tobeca/Tobeca2/AMELIORATIONS CLIENTS/poussoir-protège-doigt-tea-innovation/images/poussoir_preview_featured.jpg

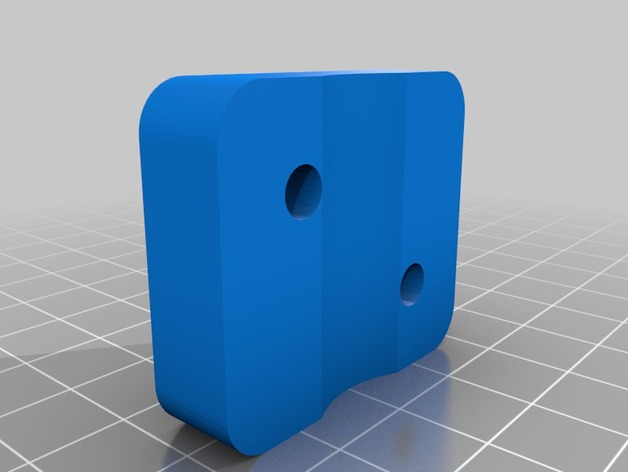
AMELIORATIONS CLIENTS/poussoir-protège-doigt-tea-innovation/images/poussoir_preview_featured.jpg
