tobeca/Tobeca2/AMELIORATIONS CLIENTS/poussoir-protège-doigt-tea-innovation/images/DSCF9553_preview_featured.JPG

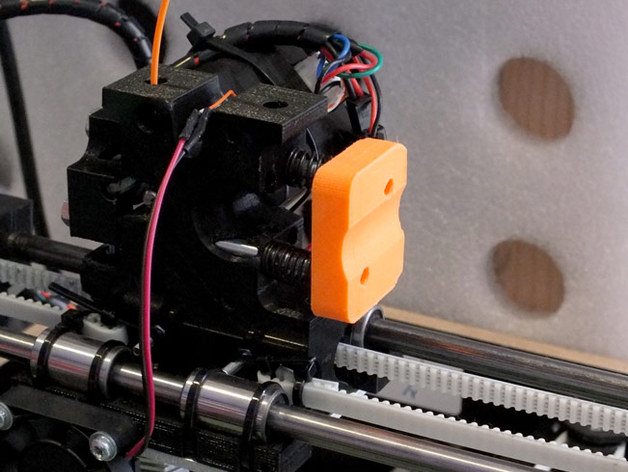
AMELIORATIONS CLIENTS/poussoir-protège-doigt-tea-innovation/images/DSCF9553_preview_featured.JPG
