tobeca/Tobeca2/README.md

<<<<<<< HEAD
Tobeca
======

The Tobeca 3D printer project
=======
Tobeca2
=======

The evolution of the 3D printer Tobeca
>>>>>>> 033404e43fc80d840fd945824806651eecf419e0
