tobeca/Tobeca2/AMELIORATIONS CLIENTS/Readme.txt

Ce dossier contient les pièces conçues et réalisées par des clients Tobeca en vue d'améliorer leur imprimante.

Elles ont été ajoutées ici par Tobeca, mais n'ont pas forcément été imprimées et testées par Tobeca. C'est pourquoi, toute modification de votre imprimante et sous votre pleine et entière responsabilité.

Si vous avez des pièces que vous jugez intéressantes à rajouter ici, merci de nous envoyer un mail à contact@tobeca.fr
