tobeca/Tobeca2/USINAGES/GCODE/CHASSIS_COTE_POIGNEE.txt

#Fichier modèle pour les perçages
#Il faut absolument respecter l'ordre suivant dans les modules : PARAMETRES, VARIABLES, INSTRUCTIONS

PARAMETRES{
	#Permet de stocker tous les paramètres de perçage/usinage qui serviront à la génération du GCODE
	ep_matiere=27; #épaisseur de la pièce à percer en mm
	marge_z=15; #marge Z au dessus de la pièce pour déplacements en mm
	f_deplacement=300; #vitesse de déplacement des axes mm/min
	f_descente=700; #vitesse du descente du forêt en mm/min
	z_passe_percer=1; #nombre de passes pour perçage
	off_x=3.5; #offset initial en X
	off_y=-1.5; #offset initial en Y
	accel=3000; #acceleration sur les déplacements
	d_fraise=3; #diamètre de la fraise
	z_passe_decouper=3; #nombre de passes pour l'usinage
	f_decoupe=500; #vitesse de découpe
	off_z=2; #offset initial en Z
	f_centrage=200; #vitesse de centrage du foret
}

VARIABLES{
	#Emplacement pour gérer directement des variables dans les instructions
	hauteur=85;
	longueur=396;
	dec_grenouille=0.5;
}

INSTRUCTIONS{
	#Positionnement des points de perçage percer, la première valeur est en X et la seconde est en Y.
	#trous du bas
	trou([55,4.5]);
	trou([165,4.5]);

	#trous planche droite
	trou([161,58]);
	trou([200,116.5]);
	trou([154,170]);
	trou([154,262]);
	trou([200,326.5]);
	trou([165,438.5]);

	#trous planche gauche
	trou([55,438.5]);
	trou([90,326.5]);
	trou([44,262]);
	trou([44,170]);
	trou([90,116.5]);
	trou([51,58]);

}
