tobeca/Tobeca2/USINAGES/GCODE/CHASSIS.txt

#Fichier modèle pour les perçages
#Il faut absolument respecter l'ordre suivant dans les modules : PARAMETRES, VARIABLES, INSTRUCTIONS

PARAMETRES{
	#Permet de stocker tous les paramètres de perçage/usinage qui serviront à la génération du GCODE
	ep_matiere=27; #épaisseur de la pièce à percer en mm
	marge_z=15; #marge Z au dessus de la pièce pour déplacements en mm
	f_deplacement=300; #vitesse de déplacement des axes mm/min
	f_descente=700; #vitesse du descente du forêt en mm/min
	z_passe_percer=1; #nombre de passes pour perçage
	off_x=3.5; #offset initial en X
	off_y=-1.5; #offset initial en Y
	accel=3000; #acceleration sur les déplacements
	d_fraise=3; #diamètre de la fraise
	z_passe_decouper=3; #nombre de passes pour l'usinage
	f_decoupe=500; #vitesse de découpe
	off_z=2; #offset initial en Z
	f_centrage=200; #vitesse de centrage du foret
}

VARIABLES{
	#Emplacement pour gérer directement des variables dans les instructions
	d_bord=4.5;
	longueur=443;
	largeur=414;
}

INSTRUCTIONS{
	trou([126,4.5]);
	trou([286,4.5]);

	#Trous de fixation du moteur
	trou([198.5,14]);
	trou([229.5,14]);
	trou([229.5,45]);
	trou([198.5,45]);

	#Trous de fixation du boitier électronique
	trou([190,87.5]);
	trou([238,168.5]);

	trou([largeur-4.5,145]);

	#Trous de fixation rangement écran LCD
	trou([380,272]);

	trou([largeur-4.5,300]);

	#Trous de fixation rangement écran LCD
	trou([380,429]);

	trou([286,longueur-4.5]);
	trou([126,longueur-4.5]);
	
	#Trous de fixation de l'alimentation électrique
	trou([234,403]);
	trou([194,248]);

	trou([4.5,300]);
	trou([4.5,145]);

}
