tobeca/Tobeca2/USINAGES/SUPPORT_AXE_X/SUPPORT_AXE_X_ALU.jpg

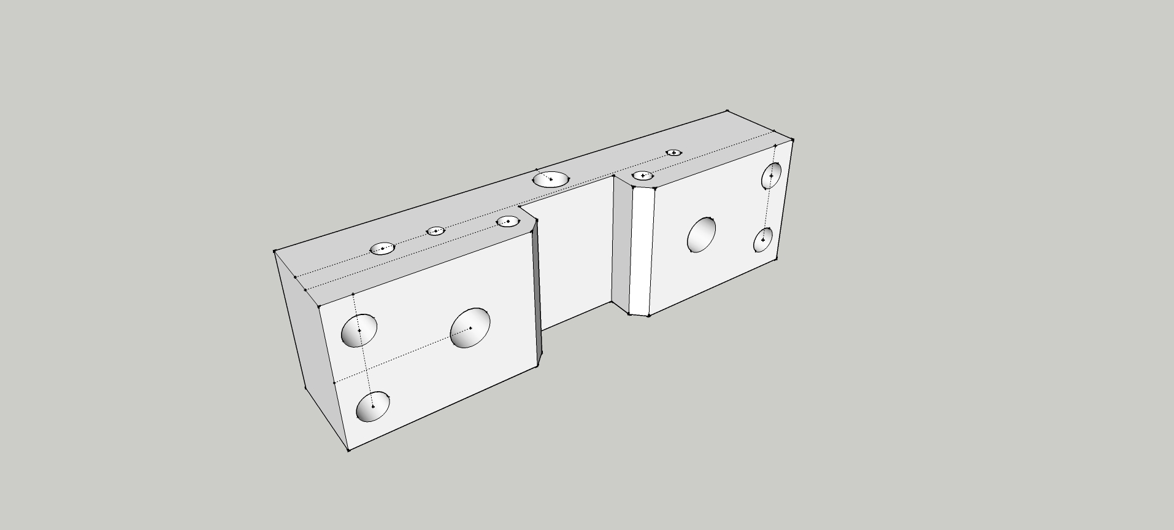
USINAGES/SUPPORT_AXE_X/SUPPORT_AXE_X_ALU.jpg
