tobeca/Tobeca2/PARTS LIST 3.3.ods

Sheet: Final
Préparation finale dans la boite |  |  |  | Préparation finale dans la boite
REF | Désignation | QTE | OK ? | REF | Désignation | QTE | OK ?
PLATEAU_PCB | Plateau chauffant PCB | 1 |  | PLATEAU_PCB | Plateau chauffant PCB | 1
THERM100K | Thermistance soudée sur le plateau ? | 1 |  | THERM100K | Thermistance soudée sur le plateau ? | 1
BOULEAU_210_210MM | Bouleau 9mm 210x210mm | 1 |  | BOULEAU_210_210MM | Bouleau 9mm 210x210mm | 1
 | Groupe guidages | 1 |  |  | Groupe guidages | 1
 | Groupe moteurs | 1 |  |  | Groupe moteurs | 1
HOTEND_1.75 | Tête d'impression avec ventilateurs | 1 |  | HOTEND_1.75 | Tête d'impression avec ventilateurs | 1
SMB-120-12 | Alimentation slim 12V 120W | 1 |  | SMB-120-12 | Alimentation slim 12V 120W | 1
POIGNEE_SANGLE | Poignée à sangle | 1 |  | POIGNEE_SANGLE | Poignée à sangle | 1
CABLE-IEC | Cordon secteur IEC mâle 2m | 1 |  | CABLE-IEC | Cordon secteur IEC mâle 2m | 1
CABLE-USB-AB | Cable USB A to B 3m | 1 |  | CABLE-USB-AB | Cable USB A to B 3m | 1
RALLONGE_USB | Rallonge USB | 1 |  | RALLONGE_USB | Rallonge USB | 1
COLLIER_NYLON_200MM | Colliers nylon 200mm | 30 |  | COLLIER_NYLON_200MM | Colliers nylon 200mm | 30
ETIQUETTE_CAPOT | Etiquette Tobeca pour capot | 1 |  | ETIQUETTE_CAPOT | Etiquette Tobeca pour capot | 1
 | Sachet de pièces imprimées | 1 |  |  | Sachet de pièces imprimées | 1
 | Sachet A | 1 |  |  | Sachet A | 1
 | Sachet B | 1 |  |  | Sachet B | 1
 | Sachet C | 1 |  |  | Sachet C | 1
 | Boite ou sachet Electronique | 1 |  |  | Boite ou sachet Electronique | 1
Préparation finale dans la boite |  |  |  | Préparation finale dans la boite
REF | Désignation | QTE | OK ? | REF | Désignation | QTE | OK ?
PLATEAU_PCB | Plateau chauffant PCB | 1 |  | PLATEAU_PCB | Plateau chauffant PCB | 1
THERM100K | Thermistance soudée sur le plateau ? | 1 |  | THERM100K | Thermistance soudée sur le plateau ? | 1
BOULEAU_210_210MM | Bouleau 9mm 210x210mm | 1 |  | BOULEAU_210_210MM | Bouleau 9mm 210x210mm | 1
 | Groupe guidages | 1 |  |  | Groupe guidages | 1
 | Groupe moteurs | 1 |  |  | Groupe moteurs | 1
HOTEND_1.75 | Tête d'impression avec ventilateurs | 1 |  | HOTEND_1.75 | Tête d'impression avec ventilateurs | 1
SMB-120-12 | Alimentation slim 12V 120W | 1 |  | SMB-120-12 | Alimentation slim 12V 120W | 1
POIGNEE_SANGLE | Poignée à sangle | 1 |  | POIGNEE_SANGLE | Poignée à sangle | 1
CABLE-IEC | Cordon secteur IEC mâle 2m | 1 |  | CABLE-IEC | Cordon secteur IEC mâle 2m | 1
CABLE-USB-AB | Cable USB A to B 3m | 1 |  | CABLE-USB-AB | Cable USB A to B 3m | 1
RALLONGE_USB | Rallonge USB | 1 |  | RALLONGE_USB | Rallonge USB | 1
COLLIER_NYLON_200MM | Colliers nylon 200mm | 30 |  | COLLIER_NYLON_200MM | Colliers nylon 200mm | 30
ETIQUETTE_CAPOT | Etiquette Tobeca pour capot | 1 |  | ETIQUETTE_CAPOT | Etiquette Tobeca pour capot | 1
 | Sachet de pièces imprimées | 1 |  |  | Sachet de pièces imprimées | 1
 | Sachet A | 1 |  |  | Sachet A | 1
 | Sachet B | 1 |  |  | Sachet B | 1
 | Sachet C | 1 |  |  | Sachet C | 1
 | Boite ou sachet Electronique | 1 |  |  | Boite ou sachet Electronique | 1

Sheet: Sachet A
SACHET A |  |  |  |  | SACHET A
REF | Désignation | QTE | OK ? |  | REF | Désignation | QTE | OK ?
TCBLZ03-008 | Vis M3x8mm tête bombée | 21 |  | 14,80g | TCBLZ03-008 | Vis M3x8mm tête bombée | 21 |  | 14,80g
TCBLZ03-012 | Vis M3x12mm tête bombée | 8 |  | 7g | TCBLZ03-012 | Vis M3x12mm tête bombée | 8 |  | 7g
TCBLZ03-020 | Vis M3x20mm tête bombée | 48 |  | 58g | TCBLZ03-020 | Vis M3x20mm tête bombée | 48 |  | 58g
TCBLZ03-030 | Vis M3x30mm tête bombée | 8 |  | 12,8g | TCBLZ03-030 | Vis M3x30mm tête bombée | 8 |  | 12,8g
TCBLZ03-040 | Vis M3x40mm tête bombée | 20 |  | 40,6g | TCBLZ03-040 | Vis M3x40mm tête bombée | 20 |  | 40,6g
TCBLZ03-060 | Vis M3x60mm tête bombée | 9 |  | 25,3g | TCBLZ03-060 | Vis M3x60mm tête bombée | 9 |  | 25,3g
TFZ03-016 | Vis M3x16mm tête fraisée | 40 |  | 30g | TFZ03-016 | Vis M3x16mm tête fraisée | 40 |  | 30g
TFZ03-020 | Vis M3x20mm tête fraisée | 8 |  | 7,3g | TFZ03-020 | Vis M3x20mm tête fraisée | 8 |  | 7,3g
TFZ03-050 | Vis M3x50mm tête fraisée | 6 |  | 10,5g | TFZ03-050 | Vis M3x50mm tête fraisée | 6 |  | 10,5g
TBHC05-014 | Vis M5x14mm 6 pans creux | 7 |  | 20g | TBHC05-014 | Vis M5x14mm 6 pans creux | 7 |  | 20g
TBHC06-035 | Vis M6x35mm 6 pans creux | 8 |  | 58g | TBHC06-035 | Vis M6x35mm 6 pans creux | 8 |  | 58g
VBATFZ03-010 | Vis agglo 3x10mm tête fraisée | 56 |  | 24,1g | VBATFZ03-010 | Vis agglo 3x10mm tête fraisée | 56 |  | 24,1g
RONM03 | Rondelles M3 standards | 136 |  | 34,6g | RONM03 | Rondelles M3 standards | 136 |  | 34,6g
ECRNYL03 | Ecrous nylstop M3 | 10 |  | 4,1g | ECRNYL03 | Ecrous nylstop M3 | 10 |  | 4,1g
ECRHU03 | Ecrous M3 | 100 |  | 33,3g | ECRHU03 | Ecrous M3 | 100 |  | 33,3g
ENTH03-010 | Ecrous M3 longs 10mm | 7 |  | 10,6g | ENTH03-010 | Ecrous M3 longs 10mm | 7 |  | 10,6g
ECRHU05 | Ecrous M5 | 2 |  |  | ECRHU05 | Ecrous M5 | 2
RONDM05 | Rondelles M5 | 2 |  |  | RONDM05 | Rondelles M5 | 2
ECRAIL08 | Ecrou M8 papillon | 1 |  |  | ECRAIL08 | Ecrou M8 papillon | 1
TH05-080 | Vis M5 80mm | 2 |  |  | TH05-080 | Vis M5 80mm | 2
TH08-100 | Vis M8x100mm | 1 |  |  | TH08-100 | Vis M8x100mm | 1
WJ200UM-11-10-LL | Patins Igus | 4 |  |  | WJ200UM-11-10-LL | Patins Igus | 4
RESSORT-10-25MM | Ressorts | 6 |  |  | RESSORT-10-25MM | Ressorts | 6
PIGNON_LAITON | Pignon laiton d'entraînement | 1 |  |  | PIGNON_LAITON | Pignon laiton d'entraînement | 1
POULIE-HTD3M-ALU | Poulie HTD3M aluminium | 2 |  |  | POULIE-HTD3M-ALU | Poulie HTD3M aluminium | 2
LM8UU | Douille linéaire 8mm | 4 |  |  | LM8UU | Douille linéaire 8mm | 4
FUSE1A | Fusible 1A 5x20mm | 2 |  |  | FUSE1A | Fusible 1A 5x20mm | 2
TUBE-12-80 | Tube inox 12mm 80mm | 1 |  |  | TUBE-12-80 | Tube inox 12mm 80mm | 1
605ZZ | Roulement 605ZZ | 3 |  |  | 605ZZ | Roulement 605ZZ | 3

Sheet: Sachet B
SACHET B |  |  |  | SACHET B
REF | Désignation | QTE | OK ? | REF | Désignation | QTE | OK ?
SC10UU | Boitier linéaire 10mm | 3 |  | SC10UU | Boitier linéaire 10mm | 3
IEC_C14 | Embase IEC C14 + interrupteur | 1 |  | IEC_C14 | Embase IEC C14 + interrupteur | 1
CABLE_NEMA17_200MM | Câble NEMA17 200mm | 1 |  | CABLE_NEMA17_200MM | Câble NEMA17 200mm | 1
CABLE_NEMA17_900MM | Câble NEMA17 900mm | 1 |  | CABLE_NEMA17_900MM | Câble NEMA17 900mm | 1
CABLE_NEMA17_1300MM | Câble NEMA17 1300mm | 1 |  | CABLE_NEMA17_1300MM | Câble NEMA17 1300mm | 1
ALU3-73x70 | Plaque alu 3mm 73x70mm | 1 |  | ALU3-73x70 | Plaque alu 3mm 73x70mm | 1
CABLE_RJ45 | Câble RJ45 (au m) | 1,5 |  | CABLE_RJ45 | Câble RJ45 (au m) | 1,5
CABLE2-075 | Câble double 0,75mm² (au m) | 1,5 |  | CABLE2-075 | Câble double 0,75mm² (au m) | 1,5
CABLEWRAP6 | Spirale de câbles | 2,5 |  | CABLEWRAP6 | Spirale de câbles | 2,5
CABLE-TERRE | Câble terre 1mm² | 10 cm |  | CABLE-TERRE | Câble terre 1mm² | 10 cm
GAINETHERMO_2MM | gaîne thermo 2mm (au m) | 10 cm |  | GAINETHERMO_2MM | gaîne thermo 2mm (au m) | 10 cm
COURROIE_HTD3M | HTD3M timing belt 840mm (au m) | 1 |  | COURROIE_HTD3M | HTD3M timing belt 840mm (au m) | 1
COURROIE_HTD3M | HTD3M timing belt 680mm (au m) | 1 |  | COURROIE_HTD3M | HTD3M timing belt 680mm (au m) | 1
SACHET B |  |  |  | SACHET B
REF | Désignation | QTE | OK ? | REF | Désignation | QTE | OK ?
SC10UU | Boitier linéaire 10mm | 3 |  | SC10UU | Boitier linéaire 10mm | 3
IEC_C14 | Embase IEC C14 + interrupteur | 1 |  | IEC_C14 | Embase IEC C14 + interrupteur | 1
CABLE_NEMA17_200MM | Câble NEMA17 200mm | 1 |  | CABLE_NEMA17_200MM | Câble NEMA17 200mm | 1
CABLE_NEMA17_900MM | Câble NEMA17 900mm | 1 |  | CABLE_NEMA17_900MM | Câble NEMA17 900mm | 1
CABLE_NEMA17_1300MM | Câble NEMA17 1300mm | 1 |  | CABLE_NEMA17_1300MM | Câble NEMA17 1300mm | 1
ALU3-73x70 | Plaque alu 3mm 73x70mm | 1 |  | ALU3-73x70 | Plaque alu 3mm 73x70mm | 1
CABLE_RJ45 | Câble RJ45 (au m) | 1,5 |  | CABLE_RJ45 | Câble RJ45 (au m) | 1,5
CABLE2-075 | Câble double 0,75mm² (au m) | 1,5 |  | CABLE2-075 | Câble double 0,75mm² (au m) | 1,5
CABLEWRAP6 | Spirale de câbles | 2,5 |  | CABLEWRAP6 | Spirale de câbles | 2,5
CABLE-TERRE | Câble terre 1mm² | 10 cm |  | CABLE-TERRE | Câble terre 1mm² | 10 cm
GAINETHERMO_2MM | gaîne thermo 2mm (au m) | 10 cm |  | GAINETHERMO_2MM | gaîne thermo 2mm (au m) | 10 cm
COURROIE_HTD3M | HTD3M timing belt 840mm (au m) | 1 |  | COURROIE_HTD3M | HTD3M timing belt 840mm (au m) | 1
COURROIE_HTD3M | HTD3M timing belt 680mm (au m) | 1 |  | COURROIE_HTD3M | HTD3M timing belt 680mm (au m) | 1
SACHET B |  |  |  | SACHET B
REF | Désignation | QTE | OK ? | REF | Désignation | QTE | OK ?
SC10UU | Boitier linéaire 10mm | 3 |  | SC10UU | Boitier linéaire 10mm | 3
IEC_C14 | Embase IEC C14 + interrupteur | 1 |  | IEC_C14 | Embase IEC C14 + interrupteur | 1
CABLE_NEMA17_200MM | Câble NEMA17 200mm | 1 |  | CABLE_NEMA17_200MM | Câble NEMA17 200mm | 1
CABLE_NEMA17_900MM | Câble NEMA17 900mm | 1 |  | CABLE_NEMA17_900MM | Câble NEMA17 900mm | 1
CABLE_NEMA17_1300MM | Câble NEMA17 1300mm | 1 |  | CABLE_NEMA17_1300MM | Câble NEMA17 1300mm | 1
ALU3-73x70 | Plaque alu 3mm 73x70mm | 1 |  | ALU3-73x70 | Plaque alu 3mm 73x70mm | 1
CABLE_RJ45 | Câble RJ45 (au m) | 1,5 |  | CABLE_RJ45 | Câble RJ45 (au m) | 1,5
CABLE2-075 | Câble double 0,75mm² (au m) | 1,5 |  | CABLE2-075 | Câble double 0,75mm² (au m) | 1,5
CABLEWRAP6 | Spirale de câbles | 2,5 |  | CABLEWRAP6 | Spirale de câbles | 2,5
CABLE-TERRE | Câble terre 1mm² | 10 cm |  | CABLE-TERRE | Câble terre 1mm² | 10 cm
GAINETHERMO_2MM | gaîne thermo 2mm (au m) | 10 cm |  | GAINETHERMO_2MM | gaîne thermo 2mm (au m) | 10 cm
COURROIE_HTD3M | HTD3M timing belt 840mm (au m) | 1 |  | COURROIE_HTD3M | HTD3M timing belt 840mm (au m) | 1
COURROIE_HTD3M | HTD3M timing belt 680mm (au m) | 1 |  | COURROIE_HTD3M | HTD3M timing belt 680mm (au m) | 1

Sheet: Sachet C
SACHET C |  |  |  | SACHET C
REF | Désignation | QTE | OK ? | REF | Désignation | QTE | OK ?
FAN404010 | Ventilateur 40x40x10mm | 1 |  | FAN404010 | Ventilateur 40x40x10mm | 1
FERMETURE_GRENOUILLE | Fermeture grenouille | 4 |  | FERMETURE_GRENOUILLE | Fermeture grenouille | 4
SUPPORT_AXE_X | SUPPORT_AXE_X aluminium | 2 |  | SUPPORT_AXE_X | SUPPORT_AXE_X aluminium | 2
COIN_METAL | Coin boule métal | 8 |  | COIN_METAL | Coin boule métal | 8
EQUERRE_METAL | Equerres de renfort | 8 |  | EQUERRE_METAL | Equerres de renfort | 8
COUPLAGE | Accouplement Z métal | 2 |  | COUPLAGE | Accouplement Z métal | 2
SACHET C |  |  |  | SACHET C
REF | Désignation | QTE | OK ? | REF | Désignation | QTE | OK ?
FAN404010 | Ventilateur 40x40x10mm | 1 |  | FAN404010 | Ventilateur 40x40x10mm | 1
FERMETURE_GRENOUILLE | Fermeture grenouille | 4 |  | FERMETURE_GRENOUILLE | Fermeture grenouille | 4
SUPPORT_AXE_X | SUPPORT_AXE_X aluminium | 2 |  | SUPPORT_AXE_X | SUPPORT_AXE_X aluminium | 2
COIN_METAL | Coin boule métal | 8 |  | COIN_METAL | Coin boule métal | 8
EQUERRE_METAL | Equerres de renfort | 8 |  | EQUERRE_METAL | Equerres de renfort | 8
COUPLAGE | Accouplement Z métal | 2 |  | COUPLAGE | Accouplement Z métal | 2
SACHET C |  |  |  | SACHET C
REF | Désignation | QTE | OK ? | REF | Désignation | QTE | OK ?
FAN404010 | Ventilateur 40x40x10mm | 1 |  | FAN404010 | Ventilateur 40x40x10mm | 1
FERMETURE_GRENOUILLE | Fermeture grenouille | 4 |  | FERMETURE_GRENOUILLE | Fermeture grenouille | 4
SUPPORT_AXE_X | SUPPORT_AXE_X aluminium | 2 |  | SUPPORT_AXE_X | SUPPORT_AXE_X aluminium | 2
COIN_METAL | Coin boule métal | 8 |  | COIN_METAL | Coin boule métal | 8
EQUERRE_METAL | Equerres de renfort | 8 |  | EQUERRE_METAL | Equerres de renfort | 8
COUPLAGE | Accouplement Z métal | 2 |  | COUPLAGE | Accouplement Z métal | 2
SACHET C |  |  |  | SACHET C
REF | Désignation | QTE | OK ? | REF | Désignation | QTE | OK ?
FAN404010 | Ventilateur 40x40x10mm | 1 |  | FAN404010 | Ventilateur 40x40x10mm | 1
FERMETURE_GRENOUILLE | Fermeture grenouille | 4 |  | FERMETURE_GRENOUILLE | Fermeture grenouille | 4
SUPPORT_AXE_X | SUPPORT_AXE_X aluminium | 2 |  | SUPPORT_AXE_X | SUPPORT_AXE_X aluminium | 2
COIN_METAL | Coin boule métal | 8 |  | COIN_METAL | Coin boule métal | 8
EQUERRE_METAL | Equerres de renfort | 8 |  | EQUERRE_METAL | Equerres de renfort | 8
COUPLAGE | Accouplement Z métal | 2 |  | COUPLAGE | Accouplement Z métal | 2
SACHET C |  |  |  | SACHET C
REF | Désignation | QTE | OK ? | REF | Désignation | QTE | OK ?
FAN404010 | Ventilateur 40x40x10mm | 1 |  | FAN404010 | Ventilateur 40x40x10mm | 1
FERMETURE_GRENOUILLE | Fermeture grenouille | 4 |  | FERMETURE_GRENOUILLE | Fermeture grenouille | 4
SUPPORT_AXE_X | SUPPORT_AXE_X aluminium | 2 |  | SUPPORT_AXE_X | SUPPORT_AXE_X aluminium | 2
COIN_METAL | Coin boule métal | 8 |  | COIN_METAL | Coin boule métal | 8
EQUERRE_METAL | Equerres de renfort | 8 |  | EQUERRE_METAL | Equerres de renfort | 8
COUPLAGE | Accouplement Z métal | 2 |  | COUPLAGE | Accouplement Z métal | 2

Sheet: Guidages
Guidages (groupe à buller et scotcher)
REF | Désignation | QTE | OK ?
WS_10_80_420 | Rail de guidage Drylin 420mm | 2
TIGEFIL-M5-330MM | Tige filetée M5 inox 330mm | 2
ARBRE10-425 | Arbre acier 10mm 425mm | 2
ARBRE8-361 | Arbre acier 8mm 361mm | 2
Guidages (groupe à buller et scotcher)
REF | Désignation | QTE | OK ?
WS_10_80_420 | Rail de guidage Drylin 420mm | 2
TIGEFIL-M5-330MM | Tige filetée M5 inox 330mm | 2
ARBRE10-425 | Arbre acier 10mm 425mm | 2
ARBRE8-361 | Arbre acier 8mm 361mm | 2
Guidages (groupe à buller et scotcher)
REF | Désignation | QTE | OK ?
WS_10_80_420 | Rail de guidage Drylin 420mm | 2
TIGEFIL-M5-330MM | Tige filetée M5 inox 330mm | 2
ARBRE10-425 | Arbre acier 10mm 425mm | 2
ARBRE8-361 | Arbre acier 8mm 361mm | 2
Guidages (groupe à buller et scotcher)
REF | Désignation | QTE | OK ?
WS_10_80_420 | Rail de guidage Drylin 420mm | 2
TIGEFIL-M5-330MM | Tige filetée M5 inox 330mm | 2
ARBRE10-425 | Arbre acier 10mm 425mm | 2
ARBRE8-361 | Arbre acier 8mm 361mm | 2
Guidages (groupe à buller et scotcher)
REF | Désignation | QTE | OK ?
WS_10_80_420 | Rail de guidage Drylin 420mm | 2
TIGEFIL-M5-330MM | Tige filetée M5 inox 330mm | 2
ARBRE10-425 | Arbre acier 10mm 425mm | 2
ARBRE8-361 | Arbre acier 8mm 361mm | 2
Guidages (groupe à buller et scotcher)
REF | Désignation | QTE | OK ?
WS_10_80_420 | Rail de guidage Drylin 420mm | 2
TIGEFIL-M5-330MM | Tige filetée M5 inox 330mm | 2
ARBRE10-425 | Arbre acier 10mm 425mm | 2
ARBRE8-361 | Arbre acier 8mm 361mm | 2
Guidages (groupe à buller et scotcher)
REF | Désignation | QTE | OK ?
WS_10_80_420 | Rail de guidage Drylin 420mm | 2
TIGEFIL-M5-330MM | Tige filetée M5 inox 330mm | 2
ARBRE10-425 | Arbre acier 10mm 425mm | 2
ARBRE8-361 | Arbre acier 8mm 361mm | 2

Sheet: Moteurs
Moteurs (buller ensemble)
REF | Désignation | QTE | OK ?
MT-1403HS100A-TB | Moteur NEMA14 | 2
MT-1704HS168A | Moteur NEMA17 | 3
Moteurs (buller ensemble)
REF | Désignation | QTE | OK ?
MT-1403HS100A-TB | Moteur NEMA14 | 2
MT-1704HS168A | Moteur NEMA17 | 3
Moteurs (buller ensemble)
REF | Désignation | QTE | OK ?
MT-1403HS100A-TB | Moteur NEMA14 | 2
MT-1704HS168A | Moteur NEMA17 | 3
Moteurs (buller ensemble)
REF | Désignation | QTE | OK ?
MT-1403HS100A-TB | Moteur NEMA14 | 2
MT-1704HS168A | Moteur NEMA17 | 3
Moteurs (buller ensemble)
REF | Désignation | QTE | OK ?
MT-1403HS100A-TB | Moteur NEMA14 | 2
MT-1704HS168A | Moteur NEMA17 | 3
Moteurs (buller ensemble)
REF | Désignation | QTE | OK ?
MT-1403HS100A-TB | Moteur NEMA14 | 2
MT-1704HS168A | Moteur NEMA17 | 3
Moteurs (buller ensemble)
REF | Désignation | QTE | OK ?
MT-1403HS100A-TB | Moteur NEMA14 | 2
MT-1704HS168A | Moteur NEMA17 | 3
Moteurs (buller ensemble)
REF | Désignation | QTE | OK ?
MT-1403HS100A-TB | Moteur NEMA14 | 2
MT-1704HS168A | Moteur NEMA17 | 3
Moteurs (buller ensemble)
REF | Désignation | QTE | OK ?
MT-1403HS100A-TB | Moteur NEMA14 | 2
MT-1704HS168A | Moteur NEMA17 | 3
Moteurs (buller ensemble)
REF | Désignation | QTE | OK ?
MT-1403HS100A-TB | Moteur NEMA14 | 2
MT-1704HS168A | Moteur NEMA17 | 3

Sheet: Pièces imprimées
Sachet de pièces imprimées |  |  | Sachet de pièces imprimées
Désignation | QTE | OK ? | Désignation | QTE | OK ?
BOITIER_RAMPS | 1 |  | BOITIER_RAMPS | 1
CAPOT_RAMPS | 1 |  | CAPOT_RAMPS | 1
PLAQUE_ARRIERE | 1 |  | PLAQUE_ARRIERE | 1
EXTRUDEUR | 1 |  | EXTRUDEUR | 1
CLIP_ENDSTOP_Y | 1 |  | CLIP_ENDSTOP_Y | 1
CLIP_PLATEAU | 1 |  | CLIP_PLATEAU | 1
EXTRUDEUR_SUPPORT_605ZZ | 1 |  | EXTRUDEUR_SUPPORT_605ZZ | 1
FIX_CHARIOT_X | 2 |  | FIX_CHARIOT_X | 2
MOLETTE_BASSE | 5 |  | MOLETTE_BASSE | 5
MOLETTE_GRANDE | 5 |  | MOLETTE_GRANDE | 5
PLAQUE_SERRAGE_FLANC | 2 |  | PLAQUE_SERRAGE_FLANC | 2
RETOUR_605ZZ | 2 |  | RETOUR_605ZZ | 2
RETOUR_X | 2 |  | RETOUR_X | 2
RETOUR_Y | 2 |  | RETOUR_Y | 2
RONDELLE_PLATEAU | 4 |  | RONDELLE_PLATEAU | 4
SUPPORT_AXE_Y | 4 |  | SUPPORT_AXE_Y | 4
SUPPORT_BOBINE | 2 |  | SUPPORT_BOBINE | 2
SUPPORT_ENDSTOP_X | 1 |  | SUPPORT_ENDSTOP_X | 1
SUPPORT_ENDSTOP_Z | 1 |  | SUPPORT_ENDSTOP_Z | 1
EQUERRE_NEMA_14 | 2 |  | EQUERRE_NEMA_14 | 2
Sachet de pièces imprimées |  |  | Sachet de pièces imprimées
Désignation | QTE | OK ? | Désignation | QTE | OK ?
BOITIER_RAMPS | 1 |  | BOITIER_RAMPS | 1
CAPOT_RAMPS | 1 |  | CAPOT_RAMPS | 1
PLAQUE_ARRIERE | 1 |  | PLAQUE_ARRIERE | 1
EXTRUDEUR | 1 |  | EXTRUDEUR | 1
CLIP_ENDSTOP_Y | 1 |  | CLIP_ENDSTOP_Y | 1
CLIP_PLATEAU | 1 |  | CLIP_PLATEAU | 1
EXTRUDEUR_SUPPORT_605ZZ | 1 |  | EXTRUDEUR_SUPPORT_605ZZ | 1
FIX_CHARIOT_X | 2 |  | FIX_CHARIOT_X | 2
MOLETTE_BASSE | 5 |  | MOLETTE_BASSE | 5
MOLETTE_GRANDE | 5 |  | MOLETTE_GRANDE | 5
PLAQUE_SERRAGE_FLANC | 2 |  | PLAQUE_SERRAGE_FLANC | 2
RETOUR_605ZZ | 2 |  | RETOUR_605ZZ | 2
RETOUR_X | 2 |  | RETOUR_X | 2
RETOUR_Y | 2 |  | RETOUR_Y | 2
RONDELLE_PLATEAU | 4 |  | RONDELLE_PLATEAU | 4
SUPPORT_AXE_Y | 4 |  | SUPPORT_AXE_Y | 4
SUPPORT_BOBINE | 2 |  | SUPPORT_BOBINE | 2
SUPPORT_ENDSTOP_X | 1 |  | SUPPORT_ENDSTOP_X | 1
SUPPORT_ENDSTOP_Z | 1 |  | SUPPORT_ENDSTOP_Z | 1
EQUERRE_NEMA_14 | 2 |  | EQUERRE_NEMA_14 | 2

Sheet: Kit Double Extrudeur
Sachet pour kit double extrudeur |  |  |  | Sachet pour kit double extrudeur
REF | Désignation | QTE | OK ? | REF | Désignation | QTE | OK ?
TBHC05-014 | Vis M5x14mm 6 pans creux | 1 |  | TBHC05-014 | Vis M5x14mm 6 pans creux | 1
RONM05 | Rondelles M5 | 2 |  | RONM05 | Rondelles M5 | 2
ECRHU05 | Ecrous M5 | 2 |  | ECRHU05 | Ecrous M5 | 2
ECRAIL08 | Ecrou M8 papillon | 1 |  | ECRAIL08 | Ecrou M8 papillon | 1
TH05-080 | Vis M5 80mm | 2 |  | TH05-080 | Vis M5 80mm | 2
TH08-100 | Vis M8x100mm | 1 |  | TH08-100 | Vis M8x100mm | 1
RESSORT-10-25MM | Ressorts | 2 |  | RESSORT-10-25MM | Ressorts | 2
PIGNON_LAITON | Pignon laiton d'entraînement | 1 |  | PIGNON_LAITON | Pignon laiton d'entraînement | 1
TUBE-12-80 | Tube inox 12mm 80mm | 1 |  | TUBE-12-80 | Tube inox 12mm 80mm | 1
605ZZ | Roulement 605ZZ | 1 |  | 605ZZ | Roulement 605ZZ | 1
CABLE_NEMA17_1300MM | Câble NEMA17 1300mm | 1 |  | CABLE_NEMA17_1300MM | Câble NEMA17 1300mm | 1
MT-1704HS168A | Moteur NEMA17 | 1 |  | MT-1704HS168A | Moteur NEMA17 | 1
HOTEND_1.75 | Tête d'impression avec ventilateur | 1 |  | HOTEND_1.75 | Tête d'impression avec ventilateur | 1
GAINETHERMO_2MM | gaîne thermo 2mm | 5 cm |  | GAINETHERMO_2MM | gaîne thermo 2mm | 5 cm
 | SUPPORT_605ZZ imprimé | 1 |  |  | SUPPORT_605ZZ imprimé | 1
 | SUPPORT_BOBINE imprimé | 2 |  |  | SUPPORT_BOBINE imprimé | 2
RONCAL12-18-0.1 | Rondelles de calage 0,1mm | 5 |  | RONCAL12-18-0.1 | Rondelles de calage 0,1mm | 5
Sachet pour kit double extrudeur |  |  |  | Sachet pour kit double extrudeur
REF | Désignation | QTE | OK ? | REF | Désignation | QTE | OK ?
TBHC05-014 | Vis M5x14mm 6 pans creux | 1 |  | TBHC05-014 | Vis M5x14mm 6 pans creux | 1
RONM05 | Rondelles M5 | 2 |  | RONM05 | Rondelles M5 | 2
ECRHU05 | Ecrous M5 | 2 |  | ECRHU05 | Ecrous M5 | 2
ECRAIL08 | Ecrou M8 papillon | 1 |  | ECRAIL08 | Ecrou M8 papillon | 1
TH05-080 | Vis M5 80mm | 2 |  | TH05-080 | Vis M5 80mm | 2
TH08-100 | Vis M8x100mm | 1 |  | TH08-100 | Vis M8x100mm | 1
RESSORT-10-25MM | Ressorts | 2 |  | RESSORT-10-25MM | Ressorts | 2
PIGNON_LAITON | Pignon laiton d'entraînement | 1 |  | PIGNON_LAITON | Pignon laiton d'entraînement | 1
TUBE-12-80 | Tube inox 12mm 80mm | 1 |  | TUBE-12-80 | Tube inox 12mm 80mm | 1
605ZZ | Roulement 605ZZ | 1 |  | 605ZZ | Roulement 605ZZ | 1
CABLE_NEMA17_1300MM | Câble NEMA17 1300mm | 1 |  | CABLE_NEMA17_1300MM | Câble NEMA17 1300mm | 1
MT-1704HS168A | Moteur NEMA17 | 1 |  | MT-1704HS168A | Moteur NEMA17 | 1
HOTEND_1.75 | Tête d'impression avec ventilateur | 1 |  | HOTEND_1.75 | Tête d'impression avec ventilateur | 1
GAINETHERMO_2MM | gaîne thermo 2mm | 5 cm |  | GAINETHERMO_2MM | gaîne thermo 2mm | 5 cm
 | SUPPORT_605ZZ imprimé | 1 |  |  | SUPPORT_605ZZ imprimé | 1
 | SUPPORT_BOBINE imprimé | 2 |  |  | SUPPORT_BOBINE imprimé | 2
RONCAL12-18-0.1 | Rondelles de calage 0,1mm | 5 |  | RONCAL12-18-0.1 | Rondelles de calage 0,1mm | 5

Sheet: Sachet Electronique
SACHET ELECTRONIQUE |  |  | SACHET ELECTRONIQUE
Désignation | QTE | OK ? | Désignation | QTE | OK ?
Carte Arduino MEGA | 1 |  | Carte Arduino MEGA | 1
Carte RAMPS 1.4 | 1 |  | Carte RAMPS 1.4 | 1
Driver moteur pas à pas | 5 |  | Driver moteur pas à pas | 5
Radiateurs sur drivers | 5 |  | Radiateurs sur drivers | 5
Contact de fin de course | 3 |  | Contact de fin de course | 3
Molex 2 voies | 1 |  | Molex 2 voies | 1
Molex 3 voies | 3 |  | Molex 3 voies | 3
Pins Molex | 14 |  | Pins Molex | 14
SACHET ELECTRONIQUE |  |  | SACHET ELECTRONIQUE
Désignation | QTE | OK ? | Désignation | QTE | OK ?
Carte Arduino MEGA | 1 |  | Carte Arduino MEGA | 1
Carte RAMPS 1.4 | 1 |  | Carte RAMPS 1.4 | 1
Driver moteur pas à pas | 5 |  | Driver moteur pas à pas | 5
Radiateurs sur drivers | 5 |  | Radiateurs sur drivers | 5
Contact de fin de course | 3 |  | Contact de fin de course | 3
Molex 2 voies | 1 |  | Molex 2 voies | 1
Molex 3 voies | 3 |  | Molex 3 voies | 3
Pins Molex | 14 |  | Pins Molex | 14
SACHET ELECTRONIQUE |  |  | SACHET ELECTRONIQUE
Désignation | QTE | OK ? | Désignation | QTE | OK ?
Carte Arduino MEGA | 1 |  | Carte Arduino MEGA | 1
Carte RAMPS 1.4 | 1 |  | Carte RAMPS 1.4 | 1
Driver moteur pas à pas | 5 |  | Driver moteur pas à pas | 5
Radiateurs sur drivers | 5 |  | Radiateurs sur drivers | 5
Contact de fin de course | 3 |  | Contact de fin de course | 3
Molex 2 voies | 1 |  | Molex 2 voies | 1
Molex 3 voies | 3 |  | Molex 3 voies | 3
Pins Molex | 14 |  | Pins Molex | 14
SACHET ELECTRONIQUE |  |  | SACHET ELECTRONIQUE
Désignation | QTE | OK ? | Désignation | QTE | OK ?
Carte Arduino MEGA | 1 |  | Carte Arduino MEGA | 1
Carte RAMPS 1.4 | 1 |  | Carte RAMPS 1.4 | 1
Driver moteur pas à pas | 5 |  | Driver moteur pas à pas | 5
Radiateurs sur drivers | 5 |  | Radiateurs sur drivers | 5
Contact de fin de course | 3 |  | Contact de fin de course | 3
Molex 2 voies | 1 |  | Molex 2 voies | 1
Molex 3 voies | 3 |  | Molex 3 voies | 3
Pins Molex | 14 |  | Pins Molex | 14

Sheet: Carter
Sachet pour kit carter |  |  | Sachet pour kit carter
Désignation | QTE | OK ? | Désignation | QTE | OK ?
Kit plaques PMMA 6mm | 1 |  | Kit plaques PMMA 6mm | 1
Equerre acier | 14 |  | Equerre acier | 14
Charnière CH05405530ZN | 2 |  | Charnière CH05405530ZN | 2
Poignée de porte polyamide | 1 |  | Poignée de porte polyamide | 1
Loquet aimanté + plaque métal | 1 |  | Loquet aimanté + plaque métal | 1
Roulements 605ZZ | 8 |  | Roulements 605ZZ | 8
Rondelles M5 standards | 36 |  | Rondelles M5 standards | 36
Vis M5x14mm | 28 |  | Vis M5x14mm | 28
Ecrous M5 | 34 |  | Ecrous M5 | 34
Rondelles M6 standards | 8 |  | Rondelles M6 standards | 8
Ecrous M6 | 8 |  | Ecrous M6 | 8
Vis M5x20mm | 6 |  | Vis M5x20mm | 6
Ecrous M5 Nylstop | 4 |  | Ecrous M5 Nylstop | 4
Tige filetée M5x195mm | 2 |  | Tige filetée M5x195mm | 2
Vis M3x12mm | 2 |  | Vis M3x12mm | 2
Vis M3x16mm | 6 |  | Vis M3x16mm | 6
Rondelles M3 | 12 |  | Rondelles M3 | 12
Ecrous M3 | 8 |  | Ecrous M3 | 8
Vis agglo 3x10mm tête bombée | 4 |  | Vis agglo 3x10mm tête bombée | 4
Sachet pour kit carter |  |  | Sachet pour kit carter
Désignation | QTE | OK ? | Désignation | QTE | OK ?
Kit plaques PMMA 6mm | 1 |  | Kit plaques PMMA 6mm | 1
Equerre acier | 14 |  | Equerre acier | 14
Charnière CH05405530ZN | 2 |  | Charnière CH05405530ZN | 2
Poignée de porte polyamide | 1 |  | Poignée de porte polyamide | 1
Loquet aimanté + plaque métal | 1 |  | Loquet aimanté + plaque métal | 1
Roulements 605ZZ | 8 |  | Roulements 605ZZ | 8
Rondelles M5 standards | 36 |  | Rondelles M5 standards | 36
Vis M5x14mm | 28 |  | Vis M5x14mm | 28
Ecrous M5 | 34 |  | Ecrous M5 | 34
Rondelles M6 standards | 8 |  | Rondelles M6 standards | 8
Ecrous M6 | 8 |  | Ecrous M6 | 8
Vis M5x20mm | 6 |  | Vis M5x20mm | 6
Ecrous M5 Nylstop | 4 |  | Ecrous M5 Nylstop | 4
Tige filetée M5x195mm | 2 |  | Tige filetée M5x195mm | 2
Vis M3x12mm | 2 |  | Vis M3x12mm | 2
Vis M3x16mm | 6 |  | Vis M3x16mm | 6
Rondelles M3 | 12 |  | Rondelles M3 | 12
Ecrous M3 | 8 |  | Ecrous M3 | 8
Vis agglo 3x10mm tête bombée | 4 |  | Vis agglo 3x10mm tête bombée | 4

Sheet: CheckList RAMPS
Check List RAMPS |  | Check List RAMPS
Désignation | OK ? | Désignation | OK ?
Flashage Arduino MEGA |  | Flashage Arduino MEGA
Ajout jumpers max endstop |  | Ajout jumpers max endstop
Vérification jumpers steppers |  | Vérification jumpers steppers
Contrôle FDC X |  | Contrôle FDC X
Contrôle FDC Y |  | Contrôle FDC Y
Contrôle FDC Z |  | Contrôle FDC Z
Mouvement X |  | Mouvement X
Mouvement Y |  | Mouvement Y
Mouvement Z |  | Mouvement Z
Chauffe tête Plateau |  | Chauffe tête Plateau
Chauffe tête E0 |  | Chauffe tête E0
Chauffe tête E1 |  | Chauffe tête E1
Mouvement E0 |  | Mouvement E0
Mouvement E1 |  | Mouvement E1
Test affichage écran LCD |  | Test affichage écran LCD
Bornier rebranché ? |  | Bornier rebranché ?
Check List RAMPS |  | Check List RAMPS
Désignation | OK ? | Désignation | OK ?
Flashage Arduino MEGA |  | Flashage Arduino MEGA
Ajout jumpers max endstop |  | Ajout jumpers max endstop
Vérification jumpers steppers |  | Vérification jumpers steppers
Contrôle FDC X |  | Contrôle FDC X
Contrôle FDC Y |  | Contrôle FDC Y
Contrôle FDC Z |  | Contrôle FDC Z
Mouvement X |  | Mouvement X
Mouvement Y |  | Mouvement Y
Mouvement Z |  | Mouvement Z
Chauffe tête Plateau |  | Chauffe tête Plateau
Chauffe tête E0 |  | Chauffe tête E0
Chauffe tête E1 |  | Chauffe tête E1
Mouvement E0 |  | Mouvement E0
Mouvement E1 |  | Mouvement E1
Test affichage écran LCD |  | Test affichage écran LCD
Bornier rebranché ? |  | Bornier rebranché ?
Check List RAMPS |  | Check List RAMPS
Désignation | OK ? | Désignation | OK ?
Flashage Arduino MEGA |  | Flashage Arduino MEGA
Ajout jumpers max endstop |  | Ajout jumpers max endstop
Vérification jumpers steppers |  | Vérification jumpers steppers
Contrôle FDC X |  | Contrôle FDC X
Contrôle FDC Y |  | Contrôle FDC Y
Contrôle FDC Z |  | Contrôle FDC Z
Mouvement X |  | Mouvement X
Mouvement Y |  | Mouvement Y
Mouvement Z |  | Mouvement Z
Chauffe tête Plateau |  | Chauffe tête Plateau
Chauffe tête E0 |  | Chauffe tête E0
Chauffe tête E1 |  | Chauffe tête E1
Mouvement E0 |  | Mouvement E0
Mouvement E1 |  | Mouvement E1
Test affichage écran LCD |  | Test affichage écran LCD
Bornier rebranché ? |  | Bornier rebranché ?
