tobeca/Tobeca2/PRINTED PARTS.ods

Désignation | Qté | Désignation | Qté
BOITIER_RAMPS | 1 | BOITIER_RAMPS | 1
CAPOT_RAMPS | 1 | CAPOT_RAMPS | 1
CLIP_ENDSTOP_Y | 1 | CLIP_ENDSTOP_Y | 1
CLIP_PLATEAU | 1 | CLIP_PLATEAU | 1
COUPLAGE_Z_SOFT | 2 | COUPLAGE_Z_SOFT | 2
EQUERRE_NEMA_14 | 2 | EQUERRE_NEMA_14 | 2
EXTRUDEUR | 1 | EXTRUDEUR | 1
EXTRUDEUR_SUPPORT_605ZZ | 1 (2) | EXTRUDEUR_SUPPORT_605ZZ | 1 (2)
FIX_CHARIOT_X | 2 | FIX_CHARIOT_X | 2
MOLETTE_GRANDE | 9 | MOLETTE_GRANDE | 9
PLAQUE_ARRIERE | 1 | PLAQUE_ARRIERE | 1
PLAQUE_SERRAGE_FLANC | 2 | PLAQUE_SERRAGE_FLANC | 2
RETOUR_605ZZ | 2 | RETOUR_605ZZ | 2
RETOUR_X | 2 | RETOUR_X | 2
RETOUR_Y | 2 | RETOUR_Y | 2
RONDELLE_PLATEAU | 4 | RONDELLE_PLATEAU | 4
SUPPORT_AXE_Y | 4 | SUPPORT_AXE_Y | 4
SUPPORT_BOBINE | 2 (4) | SUPPORT_BOBINE | 2 (4)
SUPPORT_ENDSTOP_X | 1 | SUPPORT_ENDSTOP_X | 1
SUPPORT_ENDSTOP_Z | 1 | SUPPORT_ENDSTOP_Z | 1
