tobeca/Tobeca2/AMELIORATIONS CLIENTS/modification-extrudeur-lain49/EXTRUDEUR+SUPPORT_605ZZ_modification_av_alain49.stl

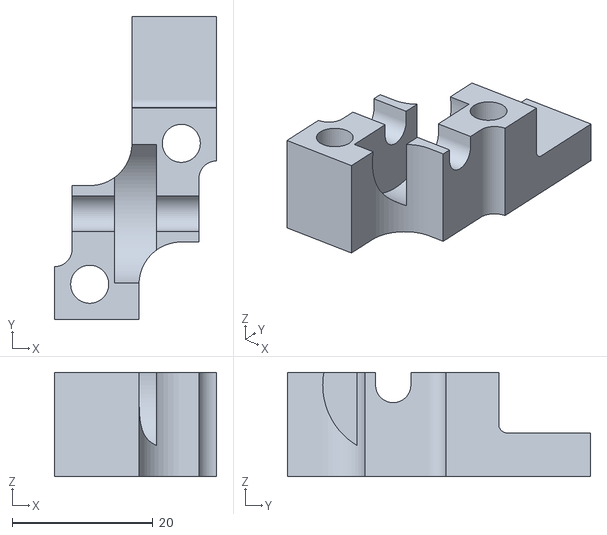
[picture p4: CAD file, 2016-04-05]
AMELIORATIONS CLIENTS/modification-extrudeur-lain49/EXTRUDEUR+SUPPORT_605ZZ_modification_av_alain49.stl
23.0 x 43.0 x 14.8
