tobeca/Tobeca2/AMELIORATIONS CLIENTS/poussoir-protège-doigt-tea-innovation/files/poussoir.stl

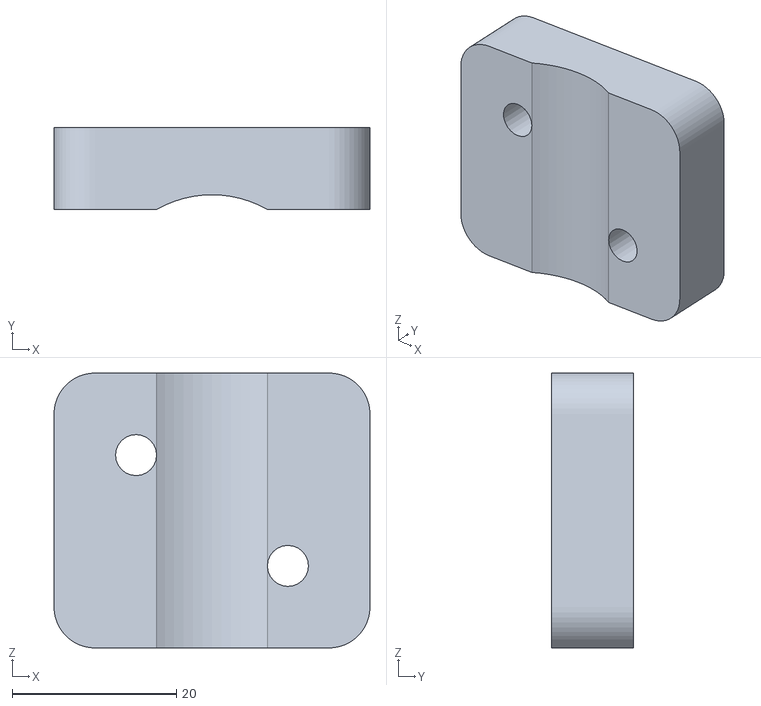
[picture p5: CAD file, 2016-04-05]
AMELIORATIONS CLIENTS/poussoir-protège-doigt-tea-innovation/files/poussoir.stl
38.5 x 10.0 x 33.5
