tobeca/Tobeca2/AMELIORATIONS CLIENTS/support-chariot-rinofly/CHARIOT VENTILO.stl

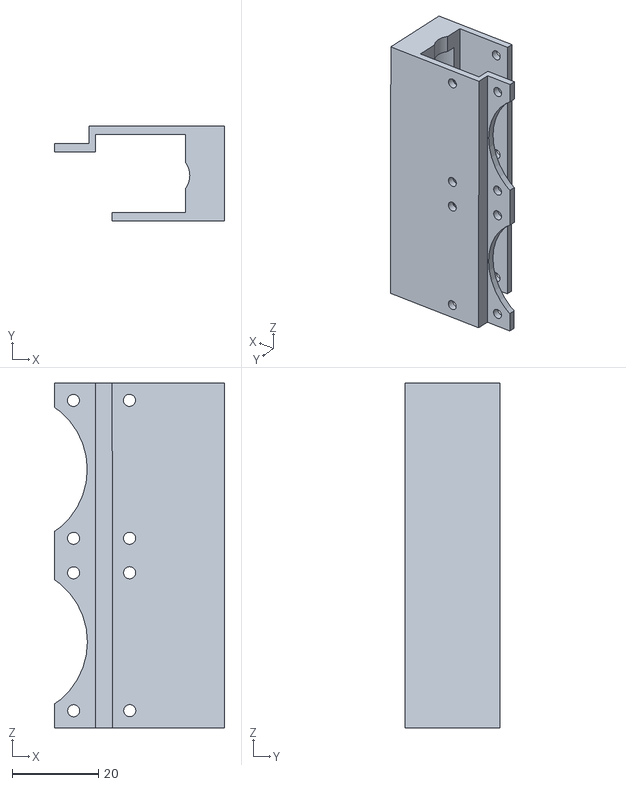
[picture p6: CAD file, 2016-04-05]
AMELIORATIONS CLIENTS/support-chariot-rinofly/CHARIOT VENTILO.stl
39.5 x 22.0 x 80.0
