tobeca/Tobeca2/AMELIORATIONS CLIENTS/support-prise-usb-alain49/support prise usb.stl

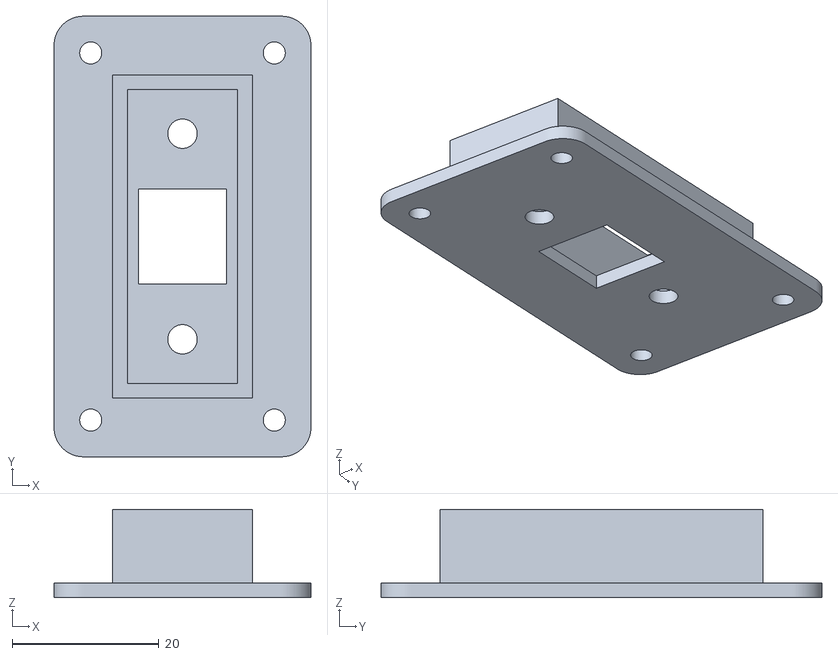
[picture p7: CAD file, 2016-04-05]
AMELIORATIONS CLIENTS/support-prise-usb-alain49/support prise usb.stl
35.0 x 60.0 x 12.0
