tobeca/Tobeca2/EN COURS D'ETUDE/PLAQUE_ARRIERE+USB.stl

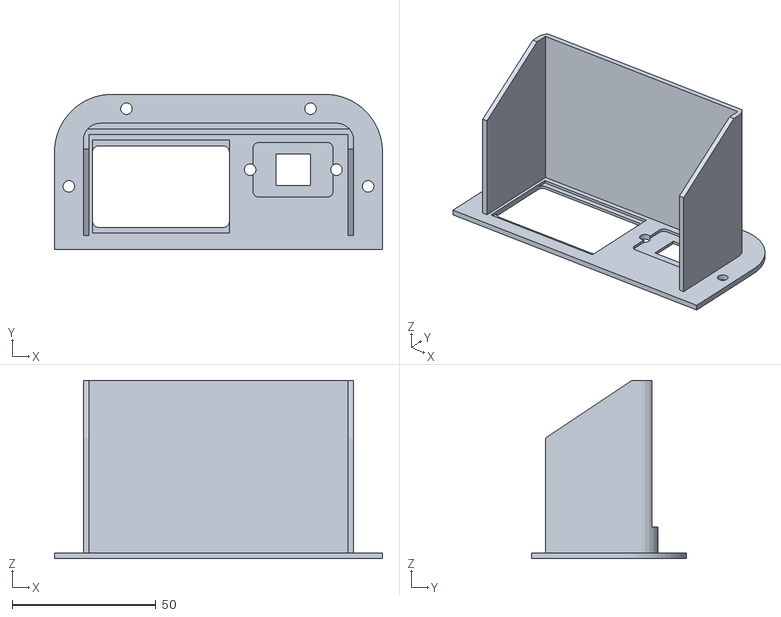
[picture p8: CAD file, 2015-10-22]
EN COURS D'ETUDE/PLAQUE_ARRIERE+USB.stl
114.0 x 54.0 x 62.0
