tobeca/Tobeca2/SKP/CARTER225/DXF CARTER 225/CARTER_ARRIERE.dxf

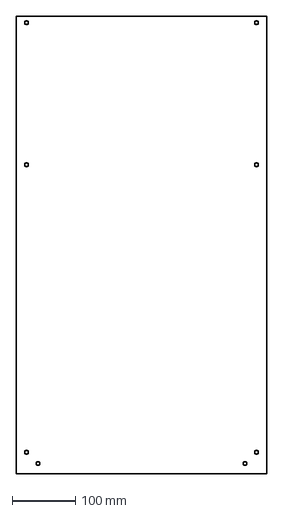
[picture p9: CAD file, 2016-04-05]
SKP/CARTER225/DXF CARTER 225/CARTER_ARRIERE.dxf
396.0 x 724.0 mm
