tobeca/Tobeca2/STL/EQUERRE_NEMA14_WANTAI_1.0.stl

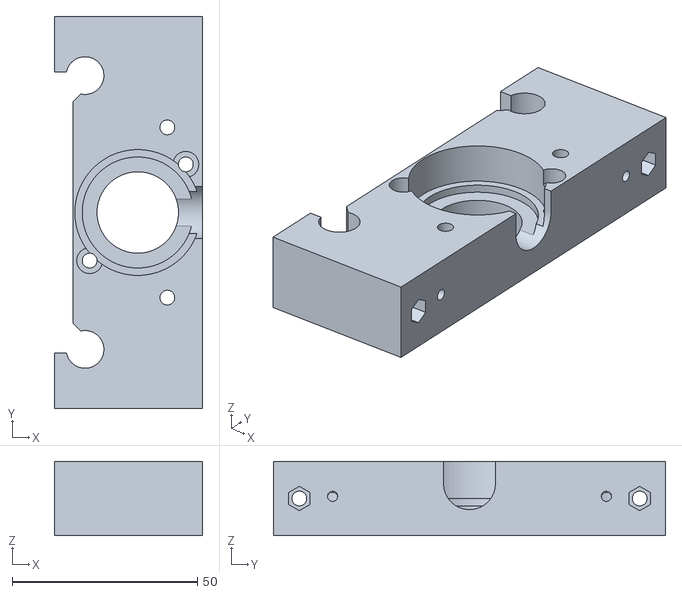
[picture p10: CAD file, 2017-01-10]
STL/EQUERRE_NEMA14_WANTAI_1.0.stl
40.0 x 106.0 x 20.0
