tobeca/Tobeca2/USINAGES/PLAQUE_ALU_X.dxf

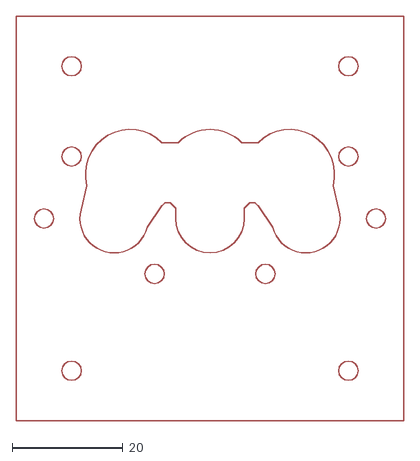
[picture p11: CAD file, 2014-07-15]
USINAGES/PLAQUE_ALU_X.dxf
70.0 x 73.0
