tobeca/Tobeca2/USINAGES/SUPPORT_AXE_X/SUPPORT_AXE_X_ALU.dxf

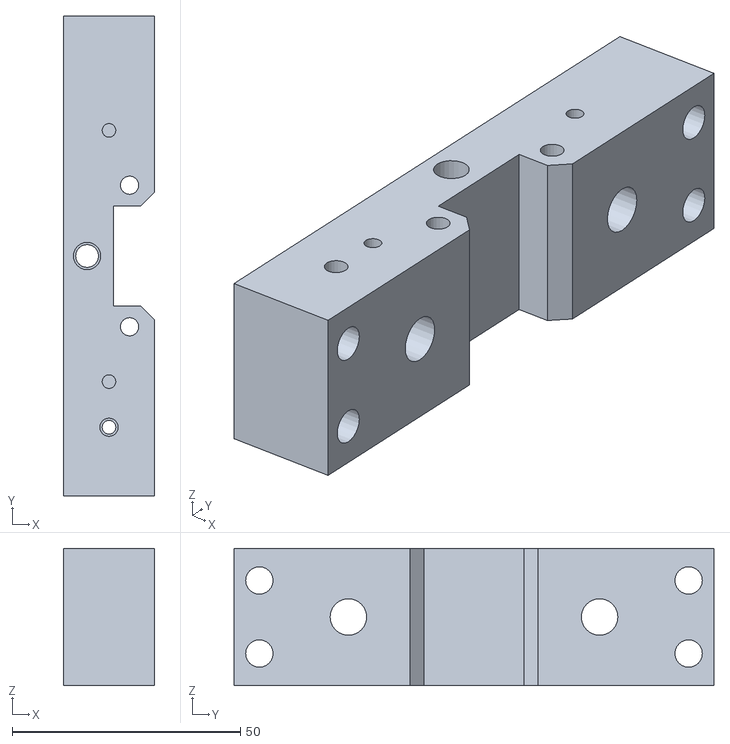
[picture p12: CAD file, 2014-09-10]
USINAGES/SUPPORT_AXE_X/SUPPORT_AXE_X_ALU.dxf
20.0 x 105.0 x 30.0
