tobeca/Tobeca2/AMELIORATIONS CLIENTS/support-chariot-rinofly/CACHE VENTILO .stl

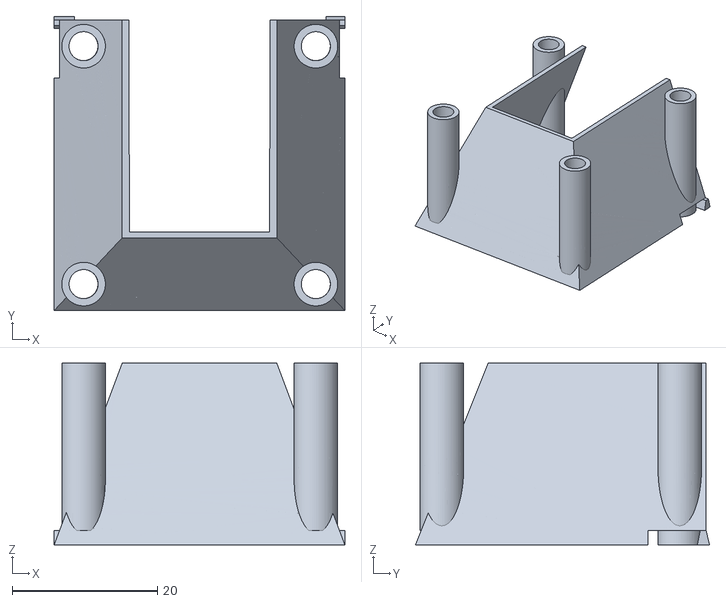
[picture p13: CAD file, 2016-04-05]
AMELIORATIONS CLIENTS/support-chariot-rinofly/CACHE VENTILO .stl
40.0 x 40.5 x 25.0
