tobeca/Tobeca2/AMELIORATIONS CLIENTS/support-prise-usb-alain49/support prise usb_ctp.stl

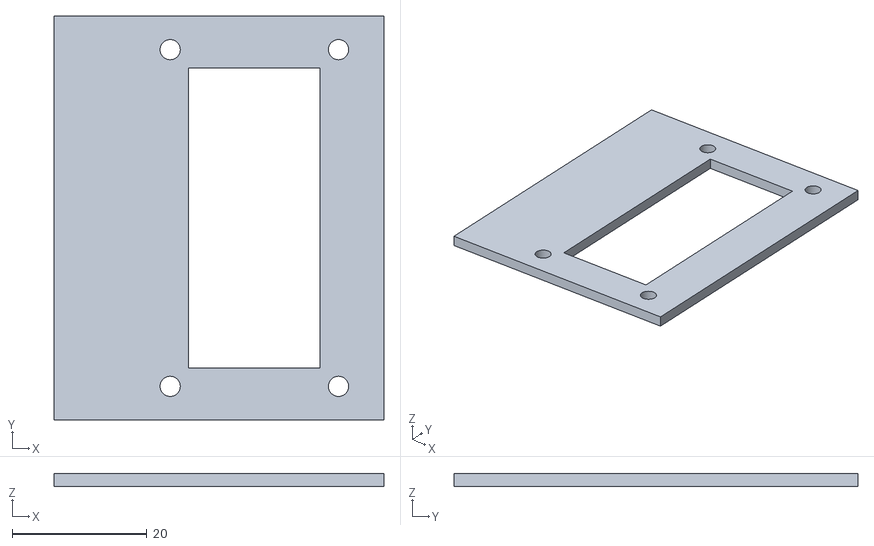
[picture p14: CAD file, 2016-04-05]
AMELIORATIONS CLIENTS/support-prise-usb-alain49/support prise usb_ctp.stl
49.0 x 60.0 x 2.00
