tobeca/Tobeca2/EN COURS D'ETUDE/EQUERRE_NEMA14_WANTAI_1.1.stl

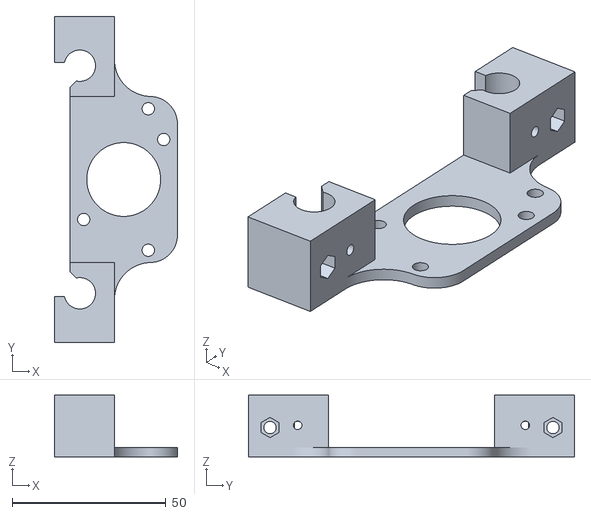
[picture p15: CAD file, 2015-04-13]
EN COURS D'ETUDE/EQUERRE_NEMA14_WANTAI_1.1.stl
40.0 x 106.0 x 20.0
