tobeca/Tobeca2/SKP/CARTER/CARTER_PMMA6MM_V5.dxf

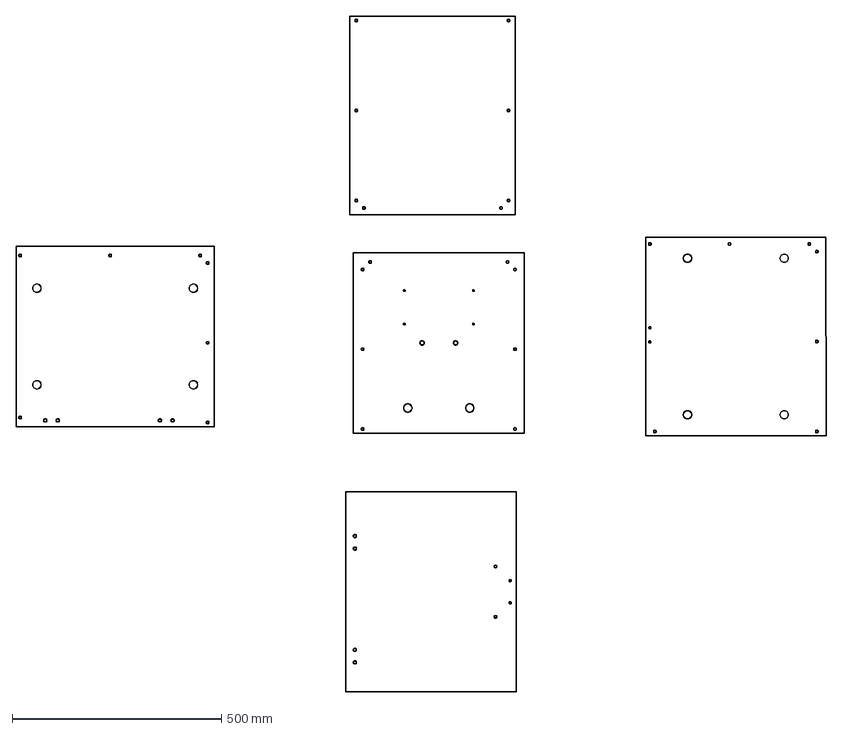
[picture p16: CAD file, 2016-12-04]
SKP/CARTER/CARTER_PMMA6MM_V5.dxf
1935.5 x 1613.9 mm
