tobeca/Tobeca2/SKP/CARTER225/DXF CARTER 225/CARTER_COTE_DROITE.dxf

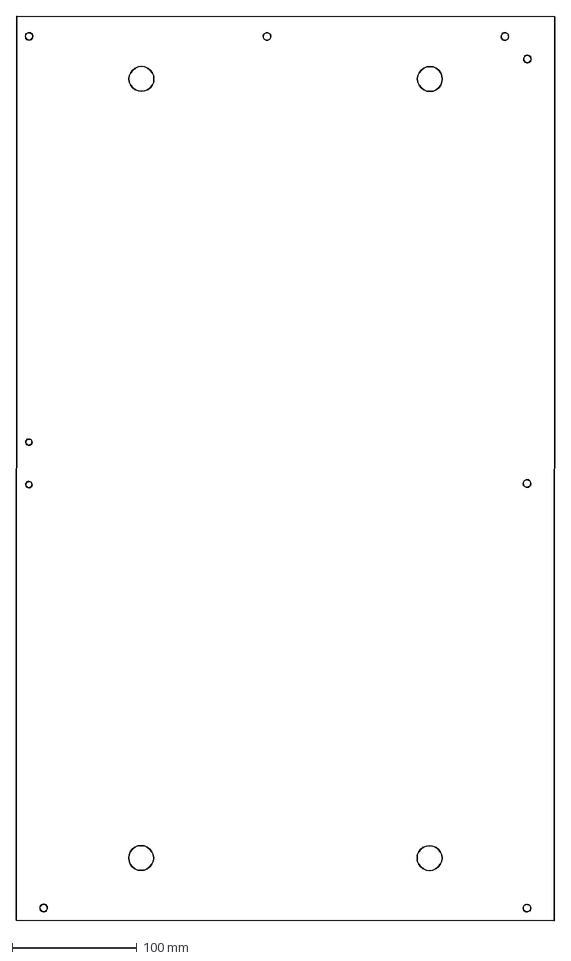
[picture p17: CAD file, 2016-04-05]
SKP/CARTER225/DXF CARTER 225/CARTER_COTE_DROITE.dxf
431.4 x 724.2 mm
