tobeca/Tobeca2/STL/EXTRUDEUR3MM.stl

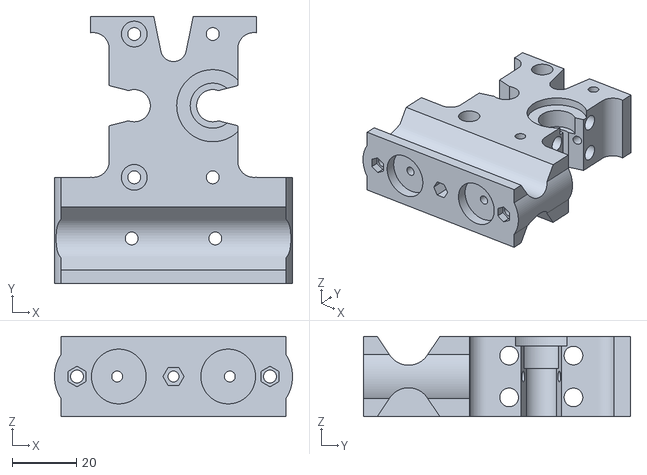
[picture p18: CAD file, 2017-01-10]
STL/EXTRUDEUR3MM.stl
74.0 x 83.0 x 25.0
