tobeca/Tobeca2/AMELIORATIONS CLIENTS/support-chariot-rinofly/SUPPORT CHARIOT HAUT.stl

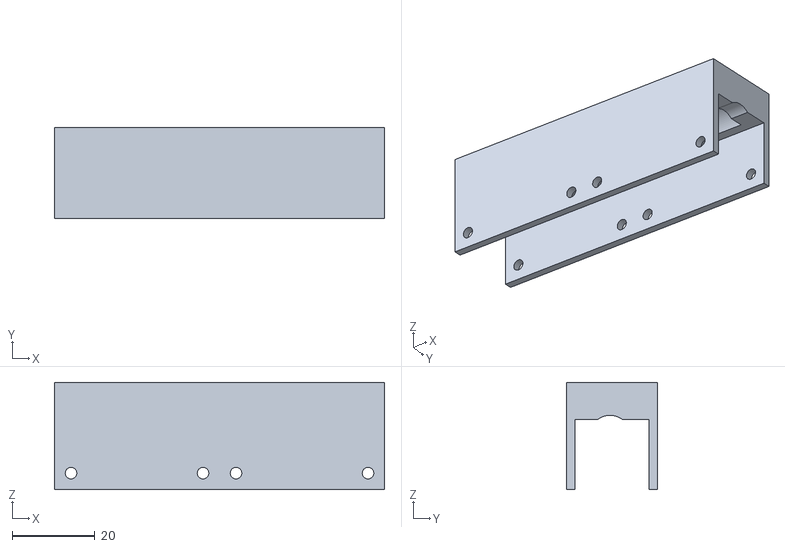
[picture p19: CAD file, 2016-04-05]
AMELIORATIONS CLIENTS/support-chariot-rinofly/SUPPORT CHARIOT HAUT.stl
80.0 x 22.0 x 26.0
