tobeca/Tobeca2/SKP/CARTER/CARTER_PMMA6MM_V3_ERREUR.dxf

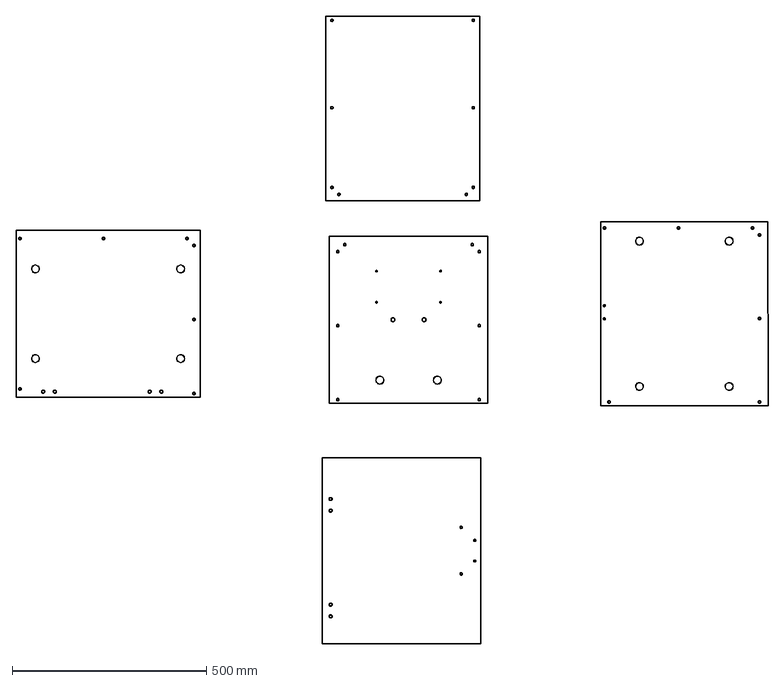
[picture p20: CAD file, 2016-04-05]
SKP/CARTER/CARTER_PMMA6MM_V3_ERREUR.dxf
1935.5 x 1613.9 mm
