tobeca/Tobeca2/SKP/CARTER225/DXF CARTER 225/CARTER_COTE_GAUCHE.dxf

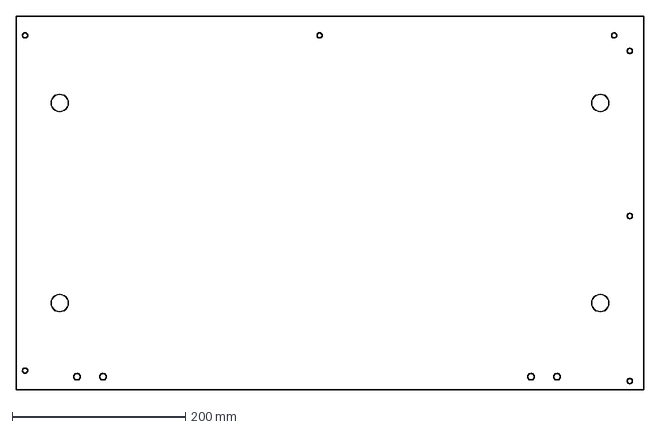
[picture p21: CAD file, 2016-04-05]
SKP/CARTER225/DXF CARTER 225/CARTER_COTE_GAUCHE.dxf
724.0 x 431.0 mm
