tobeca/Tobeca2/STL/RETOUR_605ZZ_PLAT_1.1 (d14.2).stl

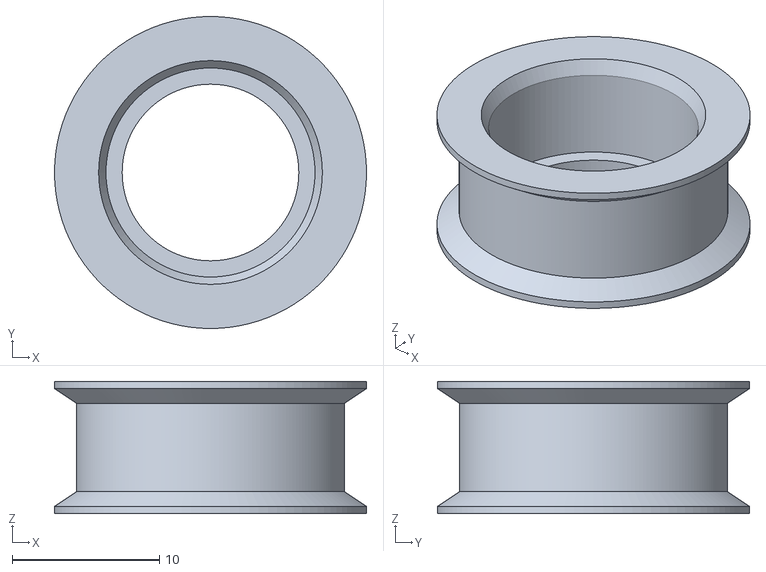
[picture p22: CAD file, 2017-01-10]
STL/RETOUR_605ZZ_PLAT_1.1 (d14.2).stl
21.2 x 21.2 x 9.00
