tobeca/Tobeca2/AMELIORATIONS CLIENTS/support-chariot-rinofly/SUPPORT CHARIOT BAS.stl

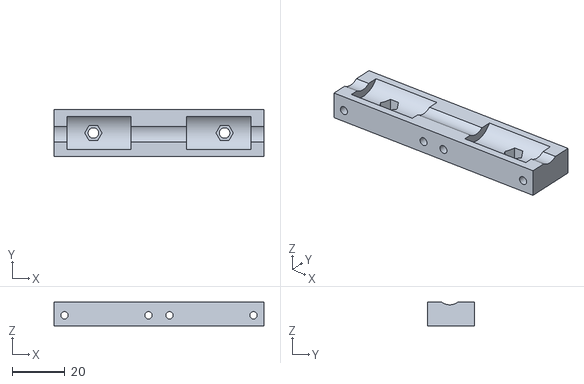
[picture p23: CAD file, 2016-04-05]
AMELIORATIONS CLIENTS/support-chariot-rinofly/SUPPORT CHARIOT BAS.stl
80.0 x 18.0 x 9.00
