tobeca/Tobeca2/SKP/CARTER225/DXF CARTER 225/CARTER_PORTE.dxf

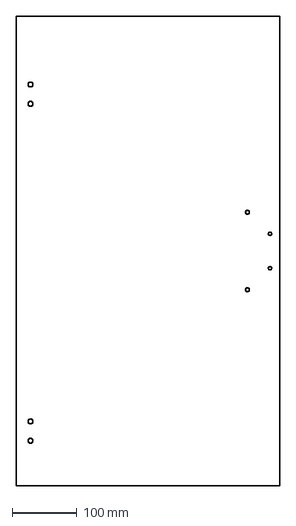
[picture p24: CAD file, 2016-04-05]
SKP/CARTER225/DXF CARTER 225/CARTER_PORTE.dxf
408.0 x 728.0 mm
