tobeca/Tobeca2/STL/CARTER_EQUERRE_AVANT_GAUCHE.stl

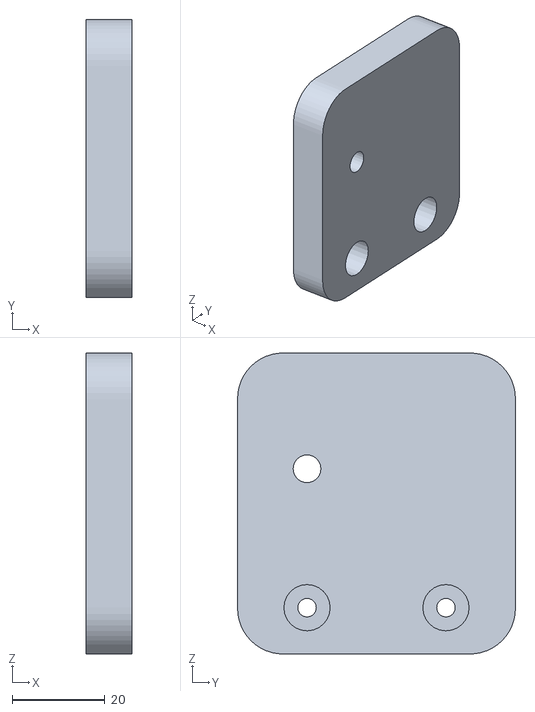
[picture p25: CAD file, 2016-12-04]
STL/CARTER_EQUERRE_AVANT_GAUCHE.stl
10.0 x 60.0 x 65.0
