tobeca/Tobeca2/SKP/CARTER225/DXF CARTER 225/CARTER_DESSUS.dxf

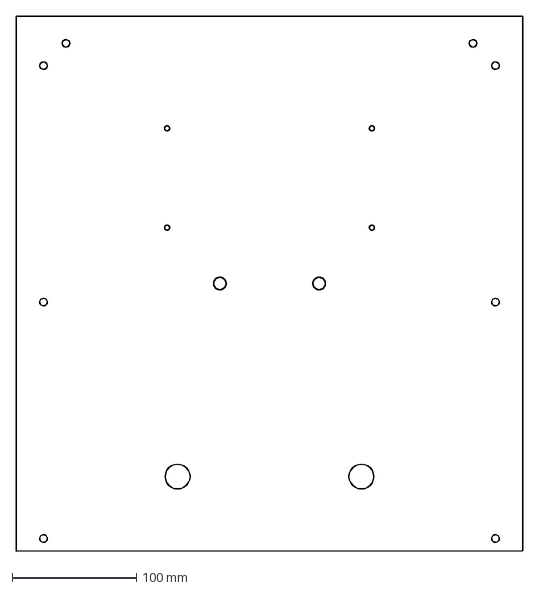
[picture p26: CAD file, 2016-04-05]
SKP/CARTER225/DXF CARTER 225/CARTER_DESSUS.dxf
408.0 x 431.0 mm
