tobeca/Tobeca2/STL/CARTER_EQUERRE_ARRIERE_GAUCHE.stl

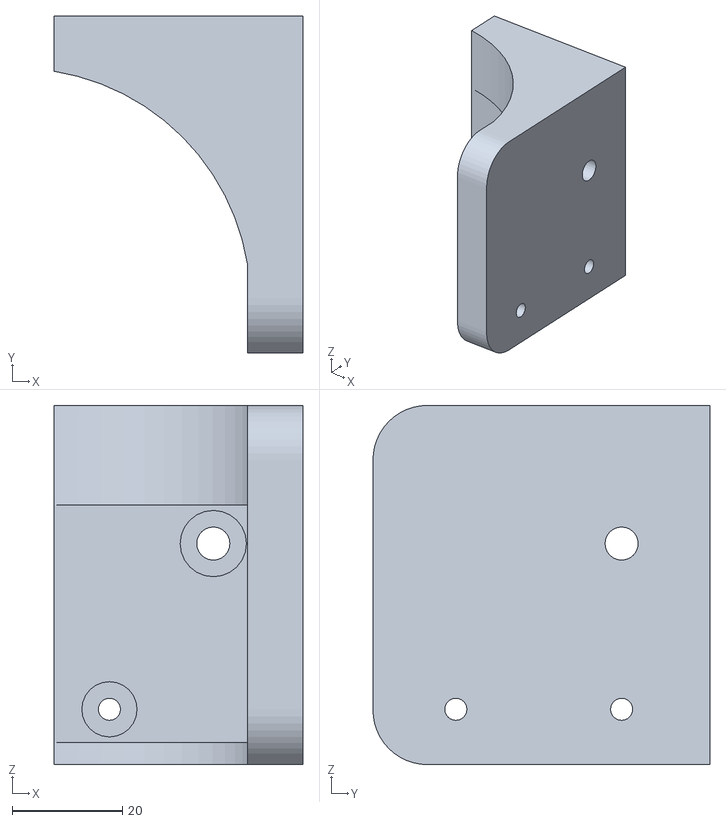
[picture p27: CAD file, 2016-12-04]
STL/CARTER_EQUERRE_ARRIERE_GAUCHE.stl
45.0 x 61.0 x 65.0
