tobeca/Tobeca2/STL/DIRIGE_FLUX_1.0.stl

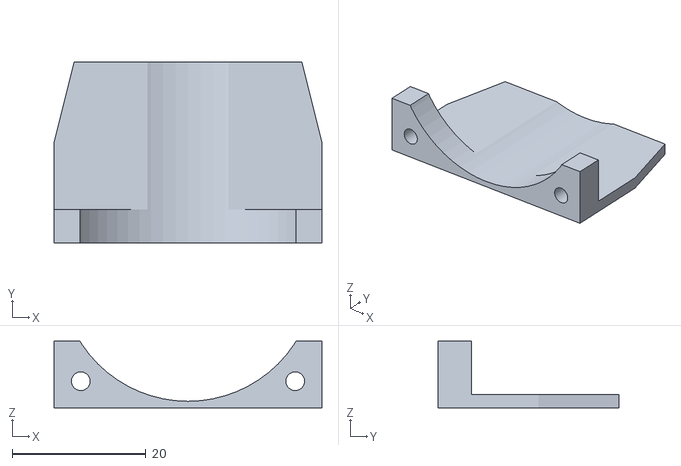
[picture p28: CAD file, 2016-12-04]
STL/DIRIGE_FLUX_1.0.stl
40.0 x 27.0 x 10.0
