tobeca/Tobeca2/STL/CARTER_EQUERRE_ARRIERE_DROITE.stl

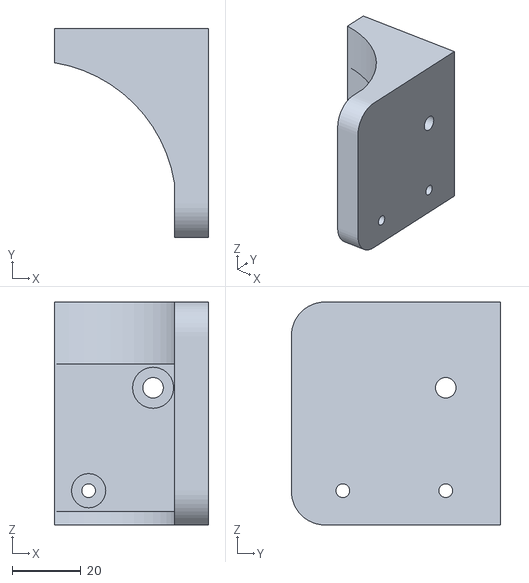
[picture p29: CAD file, 2016-12-04]
STL/CARTER_EQUERRE_ARRIERE_DROITE.stl
45.0 x 61.0 x 65.0
