tobeca/Tobeca2/STL/SUPPORT_BOBINE_605_1.1.stl

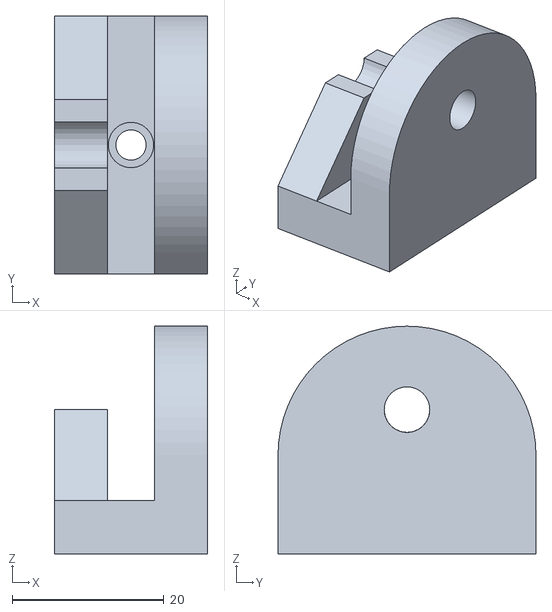
[picture p30: CAD file, 2016-05-12]
STL/SUPPORT_BOBINE_605_1.1.stl
20.2 x 34.0 x 30.0
