tobeca/Tobeca2/STL/FIX_CHARIOT_X_1.1.stl

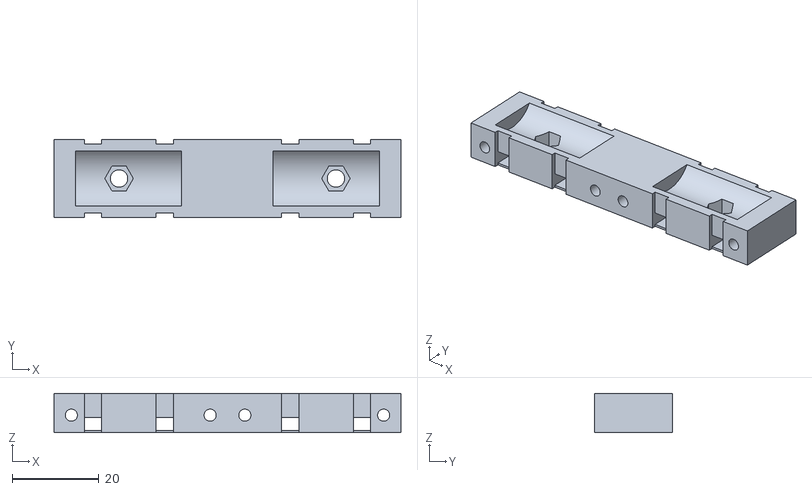
[picture p31: CAD file, 2016-01-10]
STL/FIX_CHARIOT_X_1.1.stl
80.0 x 18.0 x 9.00
