tobeca/Tobeca2/STL/SUPPORT_BOBINE_605_1.0.stl

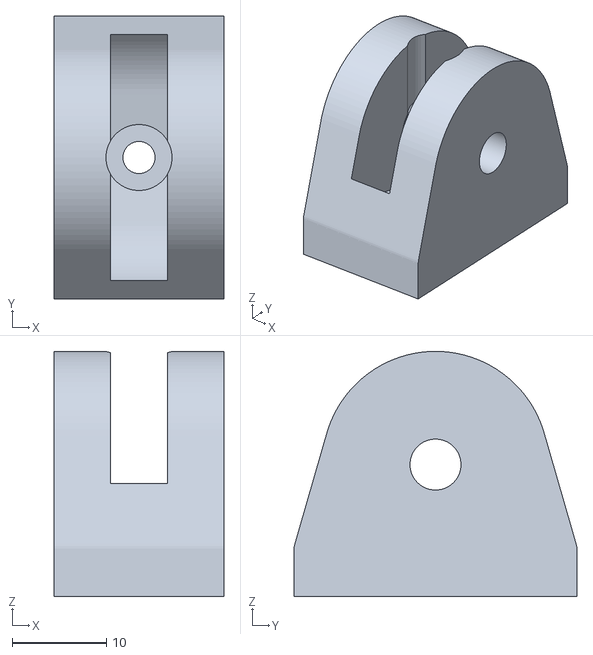
[picture p32: CAD file, 2015-12-21]
STL/SUPPORT_BOBINE_605_1.0.stl
18.0 x 30.0 x 26.0
