tobeca/Tobeca2/STL/SUPPORT_ENDSTOP_X_1.2.stl

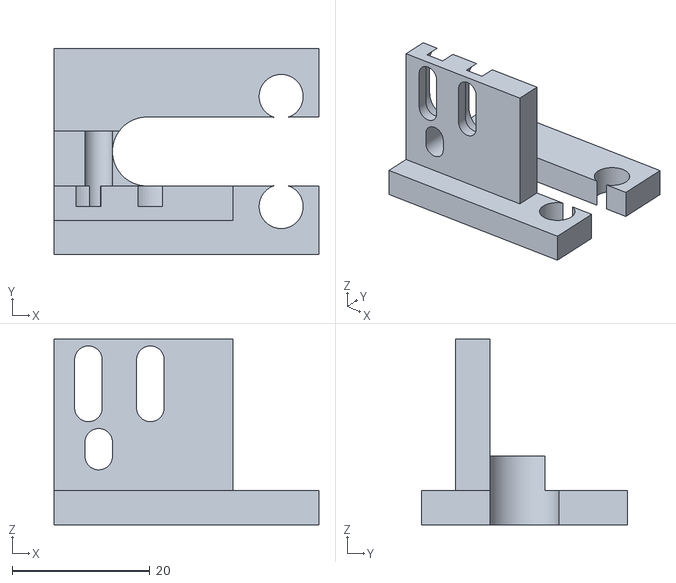
[picture p33: CAD file, 2015-12-07]
STL/SUPPORT_ENDSTOP_X_1.2.stl
38.5 x 30.0 x 27.0
