tobeca/Tobeca2/STL/BOITIER_PANELONE_1.3_FACADE.stl

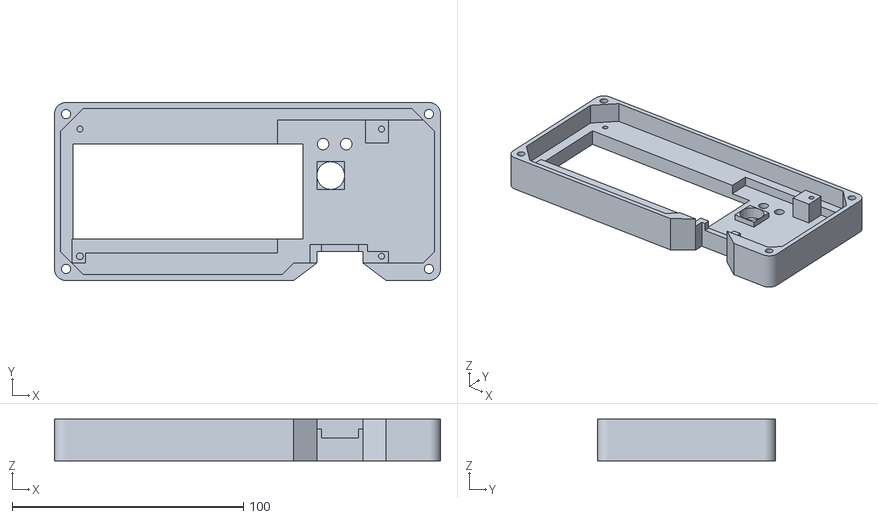
[picture p34: CAD file, 2015-12-04]
STL/BOITIER_PANELONE_1.3_FACADE.stl
167.0 x 77.0 x 18.0
