tobeca/Tobeca2/STL/BOITIER_PANELONE_1.3_ARRIERE.stl

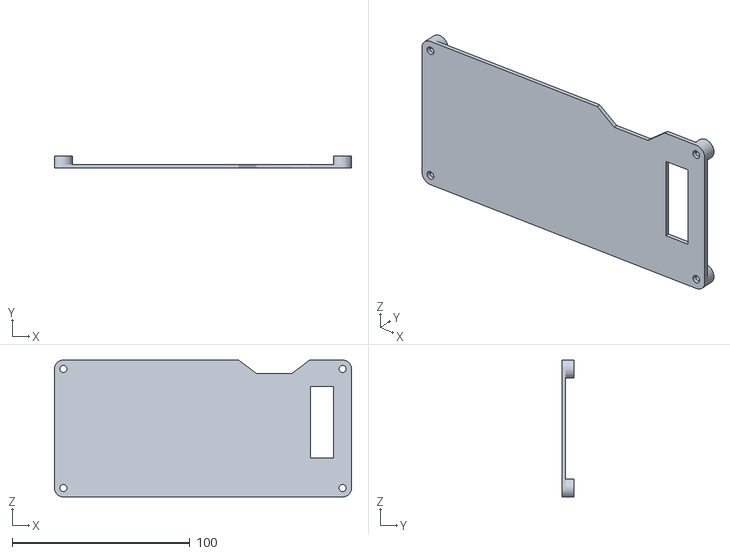
[picture p35: CAD file, 2015-12-04]
STL/BOITIER_PANELONE_1.3_ARRIERE.stl
167.0 x 7.00 x 77.0
