tobeca/Tobeca2/STL/EQUERRE_NEMA14_1.3.stl

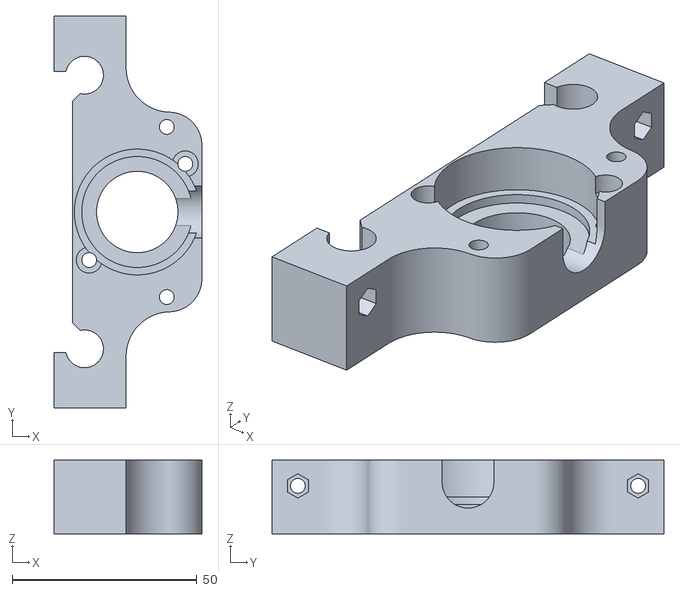
[picture p36: CAD file, 2015-11-16]
STL/EQUERRE_NEMA14_1.3.stl
40.0 x 106.0 x 20.0
