tobeca/Tobeca2/STL/PATTE_CARTER_1.0.stl

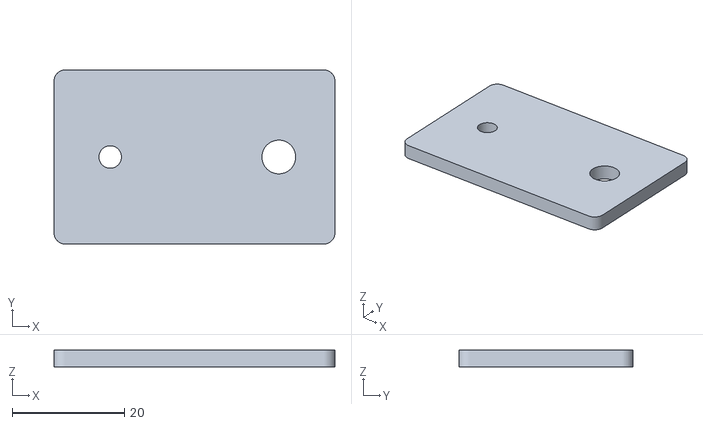
[picture p37: CAD file, 2015-11-16]
STL/PATTE_CARTER_1.0.stl
50.0 x 31.0 x 3.00
