tobeca/Tobeca2/STL/BOITIER_PANELONE_1.1_FACADE.stl

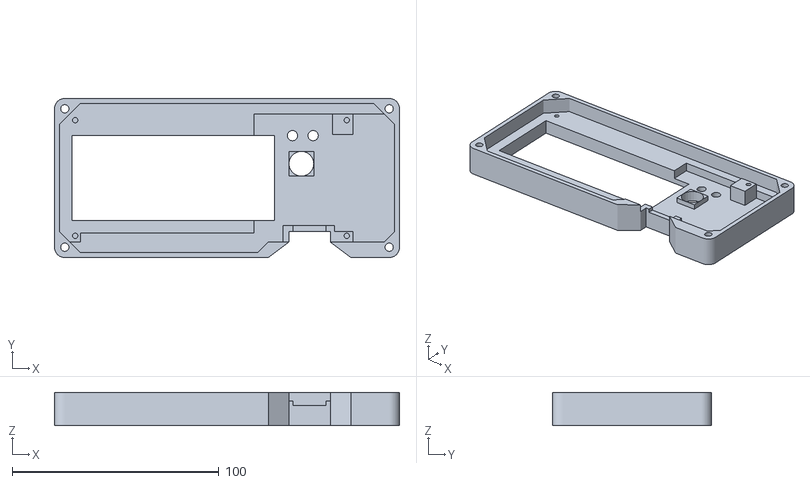
[picture p38: CAD file, 2015-11-16]
STL/BOITIER_PANELONE_1.1_FACADE.stl
167.0 x 77.0 x 16.0
