tobeca/Tobeca2/STL/BRIDAGE_PLATEAU_1.0.stl

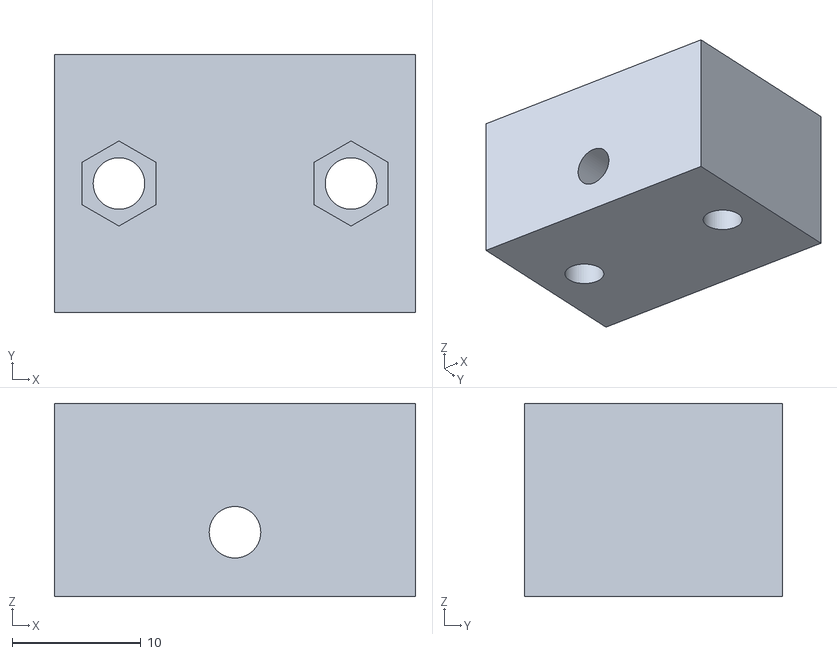
[picture p39: CAD file, 2015-10-22]
STL/BRIDAGE_PLATEAU_1.0.stl
28.0 x 20.0 x 15.0
