tobeca/Tobeca2/STL/BOUTON_LCD_1.1.stl

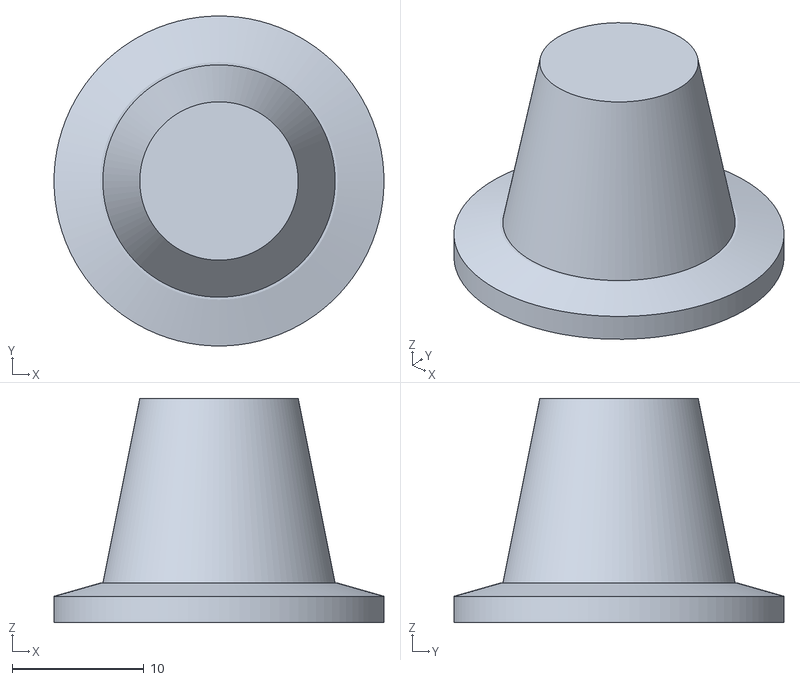
[picture p40: CAD file, 2015-10-13]
STL/BOUTON_LCD_1.1.stl
25.0 x 25.0 x 17.0
