tobeca/Tobeca2/STL/SUPPORT_ENDTOP_Z_1.1.stl

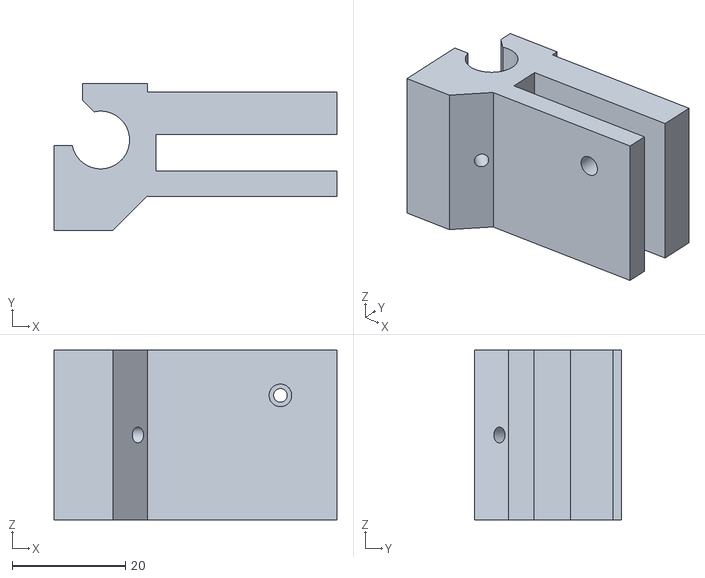
[picture p41: CAD file, 2015-10-13]
STL/SUPPORT_ENDTOP_Z_1.1.stl
50.0 x 26.0 x 30.0
