tobeca/Tobeca2/STL/BOITIER_PANELONE_1.1_ARRIERE.stl

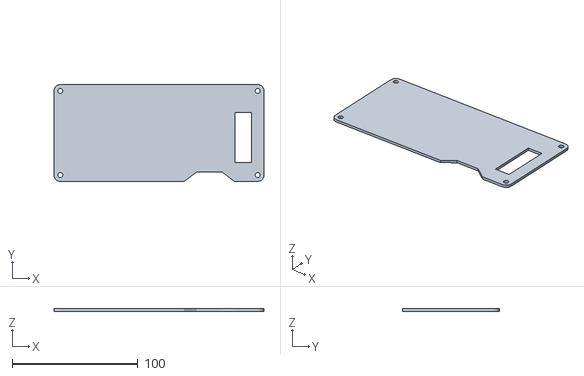
[picture p42: CAD file, 2015-10-13]
STL/BOITIER_PANELONE_1.1_ARRIERE.stl
167.0 x 77.0 x 2.00
