tobeca/Tobeca2/STL/MOLETTE_1.1.stl

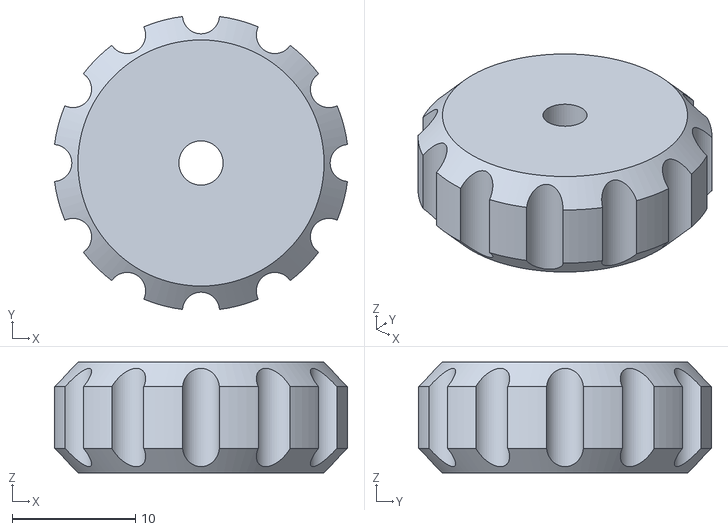
[picture p43: CAD file, 2015-10-13]
STL/MOLETTE_1.1.stl
23.8 x 23.8 x 9.00
