tobeca/Tobeca2/STL/MOLETTE_HAUTE_1.0.stl

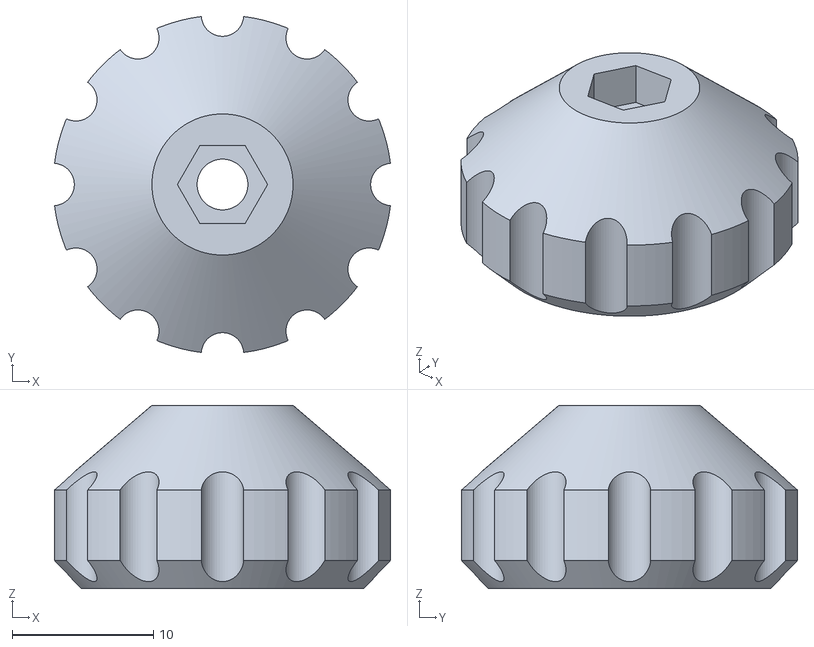
[picture p44: CAD file, 2015-10-13]
STL/MOLETTE_HAUTE_1.0.stl
23.8 x 23.8 x 13.0
