tobeca/Tobeca2/STL/PLAQUE_SERRAGE_FLANC_2.1.stl

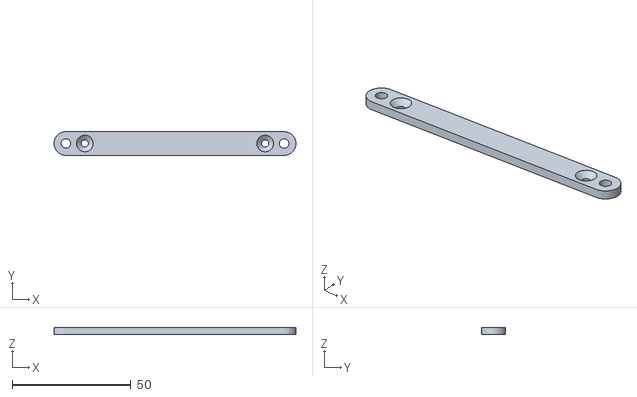
[picture p45: CAD file, 2015-10-13]
STL/PLAQUE_SERRAGE_FLANC_2.1.stl
102.0 x 9.98 x 3.00
