tobeca/Tobeca2/STL/CALE_PORTE.stl

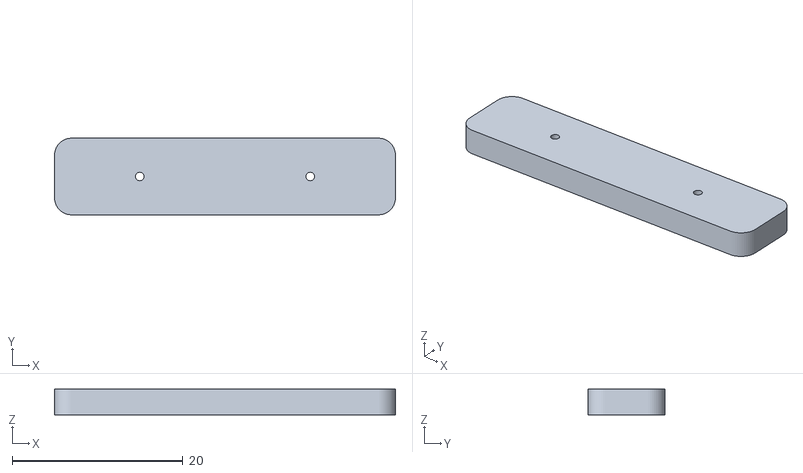
[picture p46: CAD file, 2015-09-04]
STL/CALE_PORTE.stl
40.0 x 8.99 x 3.00
