tobeca/Tobeca2/STL/EXTRUDEUR_SUPPORT_605ZZ_1.1.stl

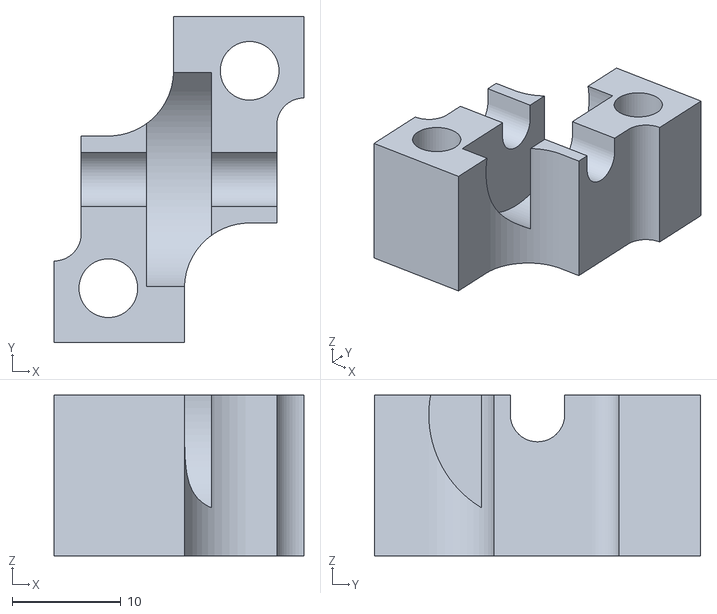
[picture p47: CAD file, 2015-06-26]
STL/EXTRUDEUR_SUPPORT_605ZZ_1.1.stl
23.0 x 30.0 x 14.8
