tobeca/Tobeca2/STL/SUPPORT_ENDSTOP_X_1.1.stl

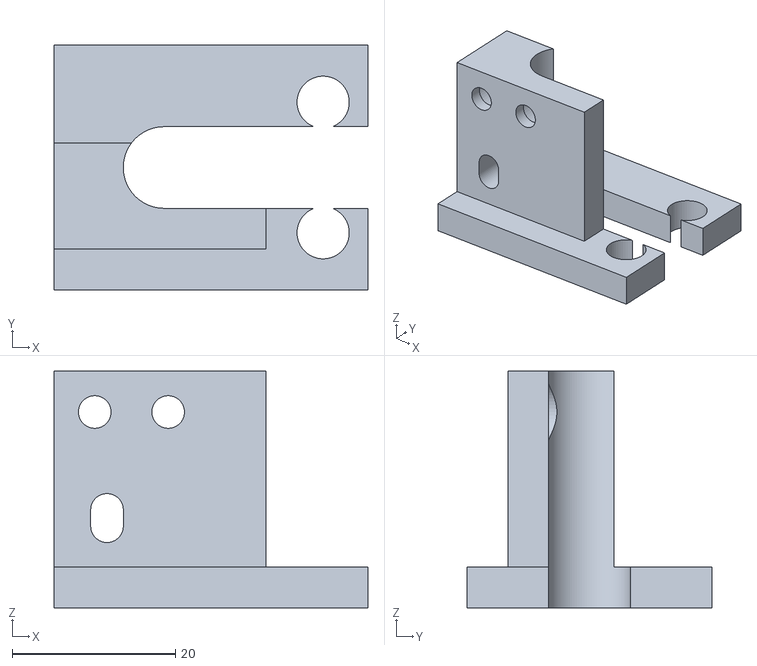
[picture p48: CAD file, 2015-06-26]
STL/SUPPORT_ENDSTOP_X_1.1.stl
38.5 x 30.0 x 29.0
