tobeca/Tobeca2/STL/EXTRUDEUR_2.2.stl

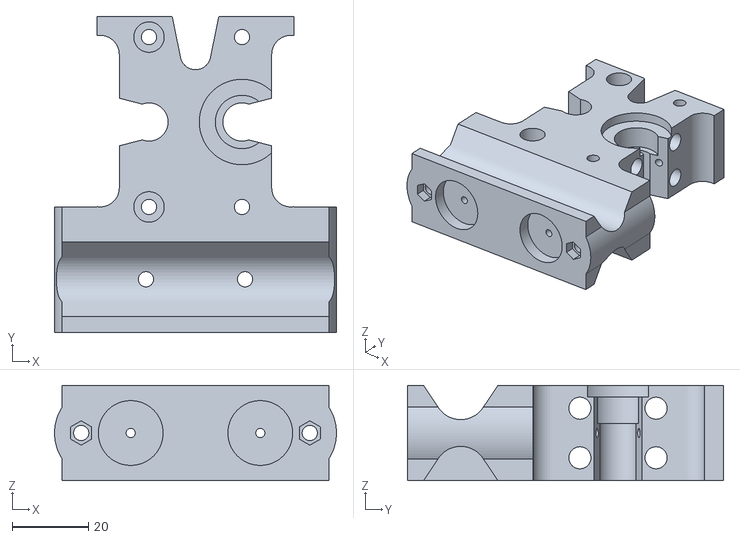
[picture p49: CAD file, 2015-04-29]
STL/EXTRUDEUR_2.2.stl
74.0 x 83.0 x 25.0
