tobeca/Tobeca2/STL/FLANC_LCD_DROITE_1.0.stl

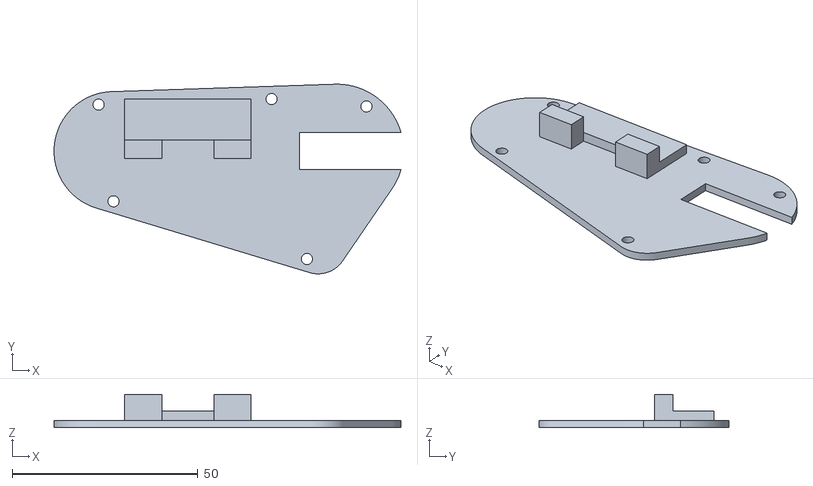
[picture p50: CAD file, 2015-04-29]
STL/FLANC_LCD_DROITE_1.0.stl
93.3 x 51.0 x 9.00
