tobeca/Tobeca2/STL/EXTRUDEUR_2.1.stl

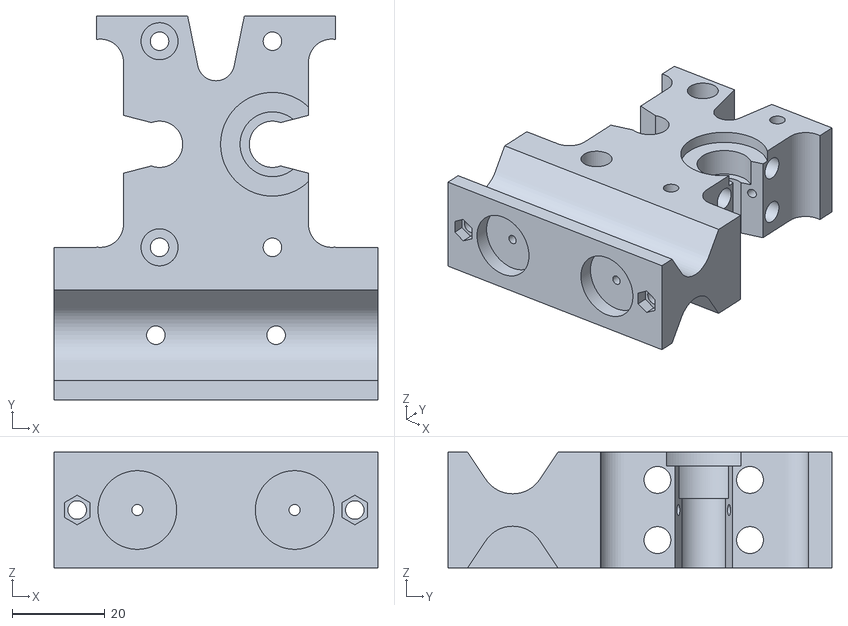
[picture p51: CAD file, 2015-04-29]
STL/EXTRUDEUR_2.1.stl
70.0 x 83.0 x 25.0
