tobeca/Tobeca2/STL/BOITIER_LCD_1.0.stl

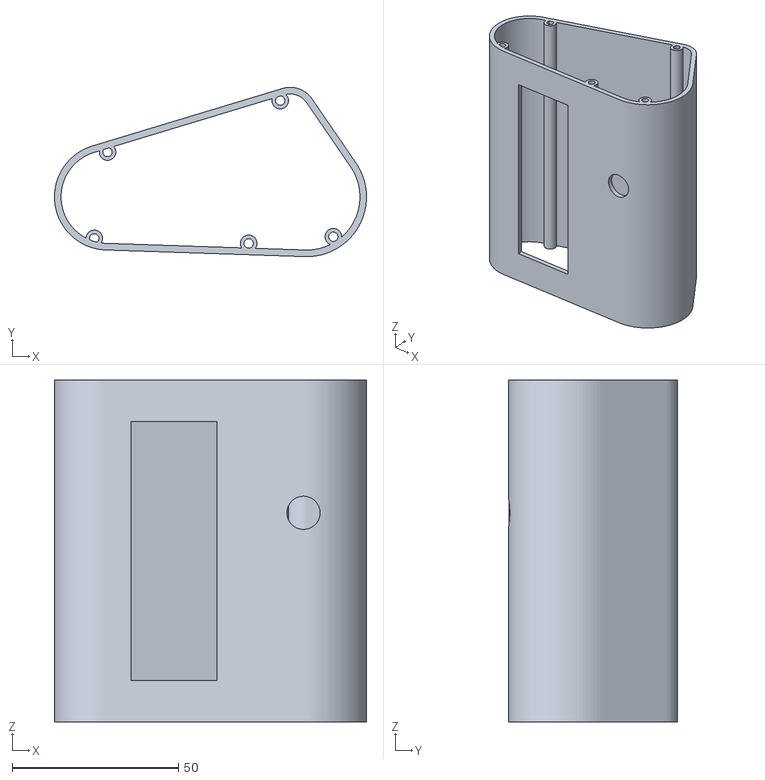
[picture p52: CAD file, 2015-04-13]
STL/BOITIER_LCD_1.0.stl
94.0 x 51.0 x 103.0
