tobeca/Tobeca2/STL/BOUTON_LCD_1.0.stl

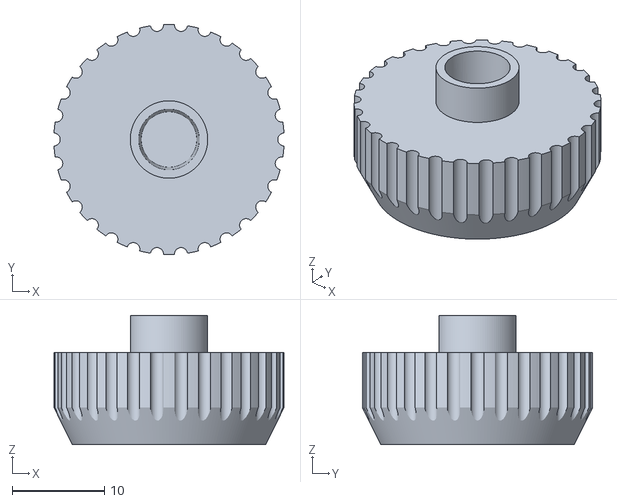
[picture p53: CAD file, 2015-04-13]
STL/BOUTON_LCD_1.0.stl
25.0 x 25.0 x 14.0
