tobeca/Tobeca2/STL/EXTRUDEUR_2.0.stl

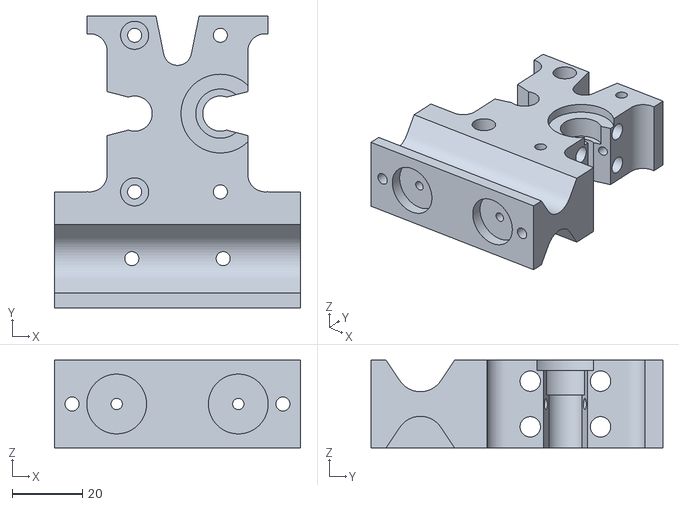
[picture p54: CAD file, 2015-02-05]
STL/EXTRUDEUR_2.0.stl
70.0 x 83.0 x 25.0
