tobeca/Tobeca2/STL/RETOUR_X_1.0.stl

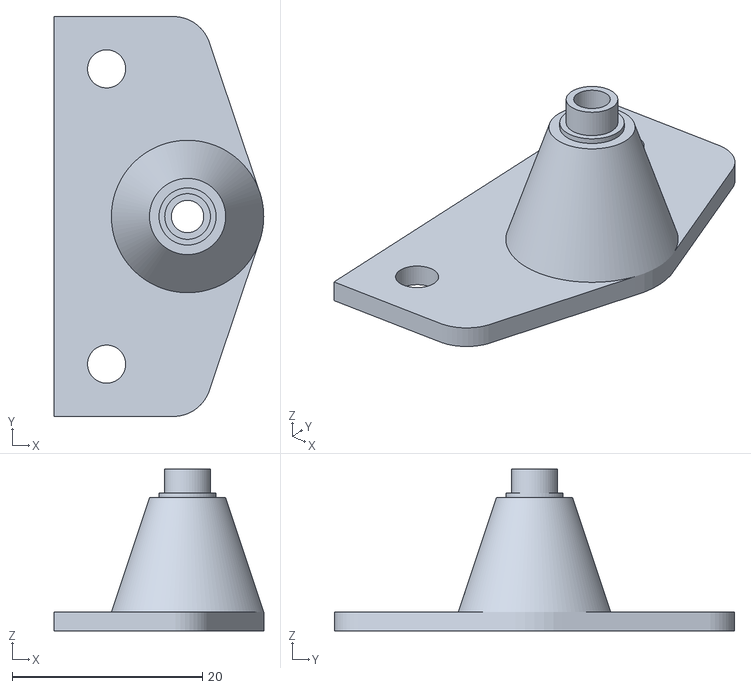
[picture p55: CAD file, 2015-02-05]
STL/RETOUR_X_1.0.stl
22.0 x 42.0 x 17.0
