tobeca/Tobeca2/STL/RONDELLE_PLATEAU_1.0.stl

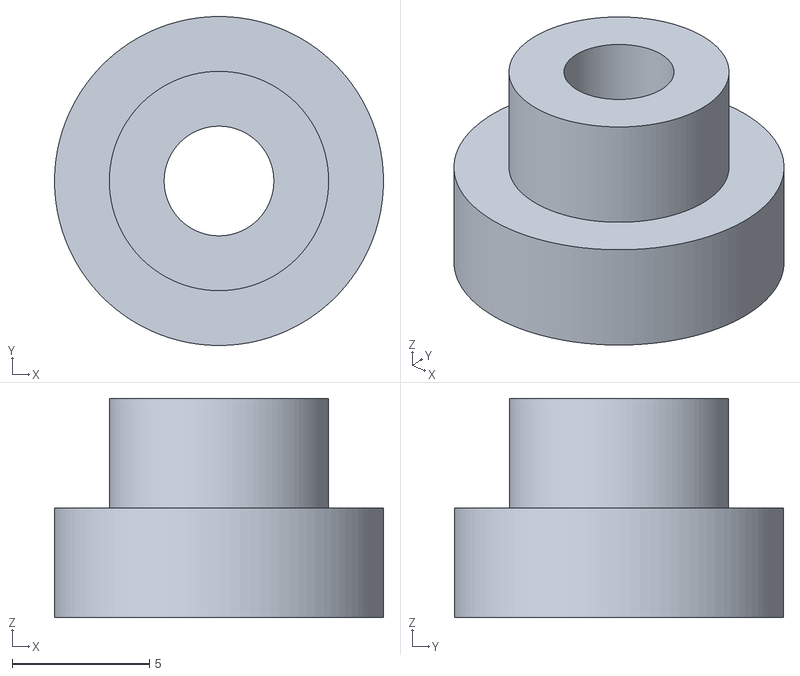
[picture p56: CAD file, 2015-02-05]
STL/RONDELLE_PLATEAU_1.0.stl
12.0 x 12.0 x 8.00
