tobeca/Tobeca2/STL/RETOUR_Y_2.0.stl

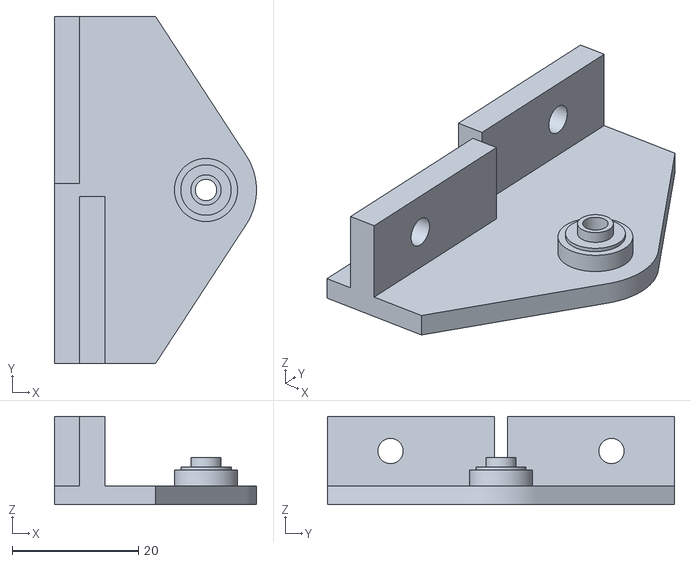
[picture p57: CAD file, 2015-02-05]
STL/RETOUR_Y_2.0.stl
32.0 x 55.0 x 14.0
