tobeca/Tobeca2/STL/COUPLAGE_Z_SOFT_1.0.stl

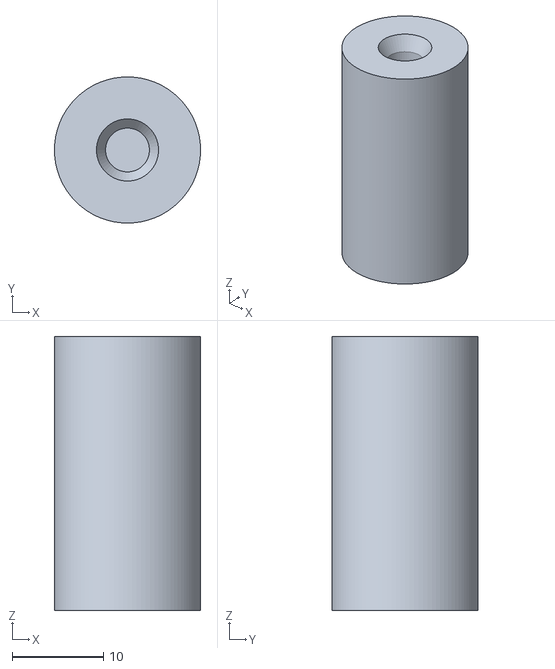
[picture p58: CAD file, 2015-02-05]
STL/COUPLAGE_Z_SOFT_1.0.stl
16.0 x 16.0 x 30.0
