tobeca/Tobeca2/STL/MOLETTE_1.0.stl

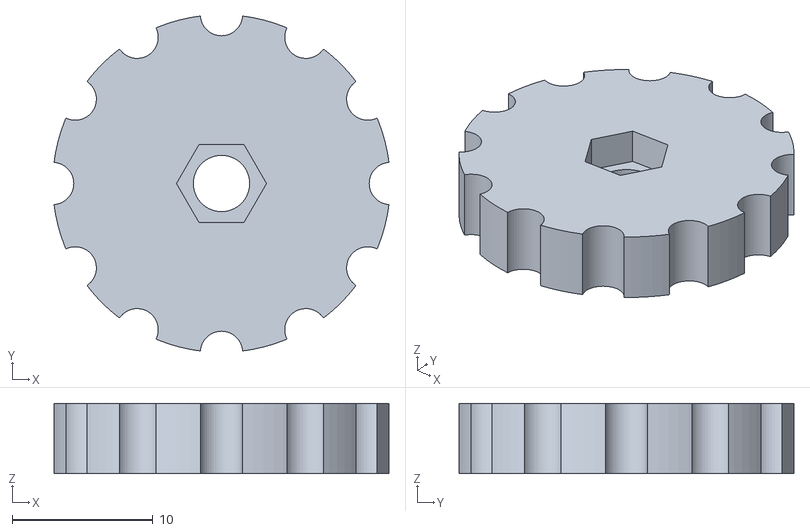
[picture p59: CAD file, 2015-02-05]
STL/MOLETTE_1.0.stl
23.8 x 23.8 x 5.00
