tobeca/Tobeca2/STL/GUIDE_CABLE_Z_1.0.stl

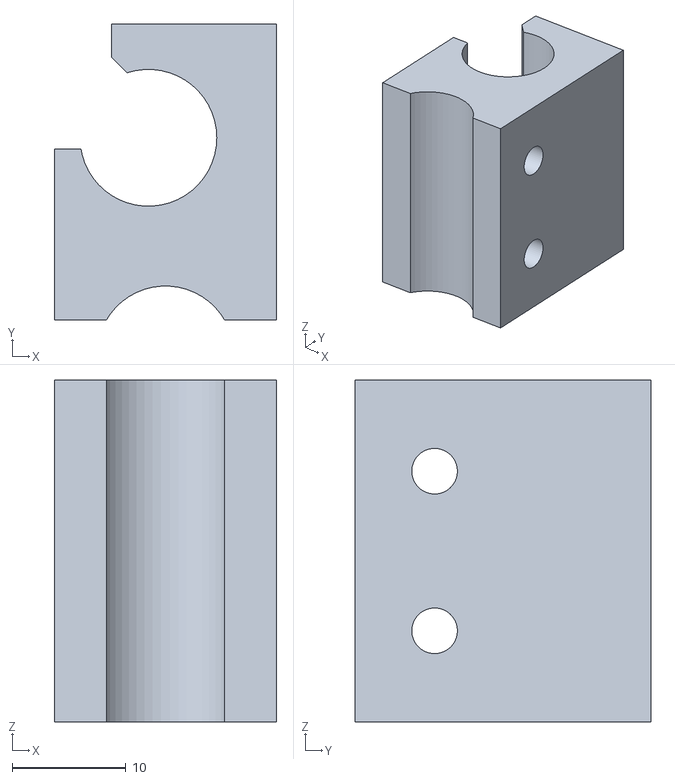
[picture p60: CAD file, 2015-02-05]
STL/GUIDE_CABLE_Z_1.0.stl
19.5 x 26.0 x 30.0
