tobeca/Tobeca2/STL/CAPOT_RAMPS_1.0.stl

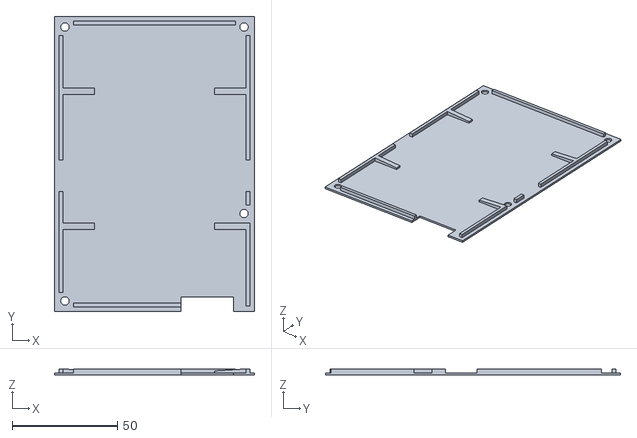
[picture p61: CAD file, 2015-01-13]
STL/CAPOT_RAMPS_1.0.stl
95.0 x 140.0 x 3.00
