tobeca/Tobeca2/STL/BOITIER_RAMPS_1.0.stl

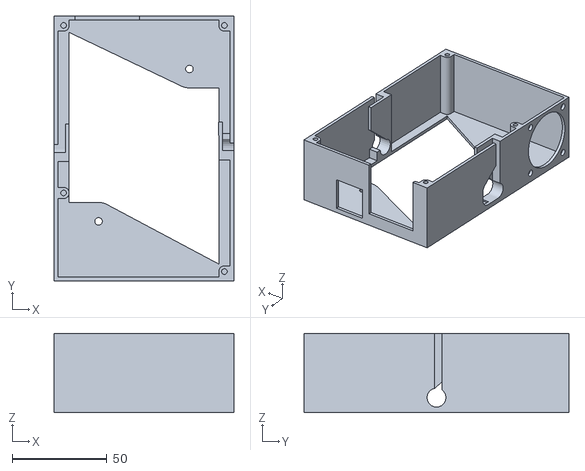
[picture p62: CAD file, 2015-01-13]
STL/BOITIER_RAMPS_1.0.stl
95.0 x 140.0 x 42.0
