tobeca/Tobeca2/STL/RETOUR_605ZZ_PLAT_1.0 (d14.5).stl

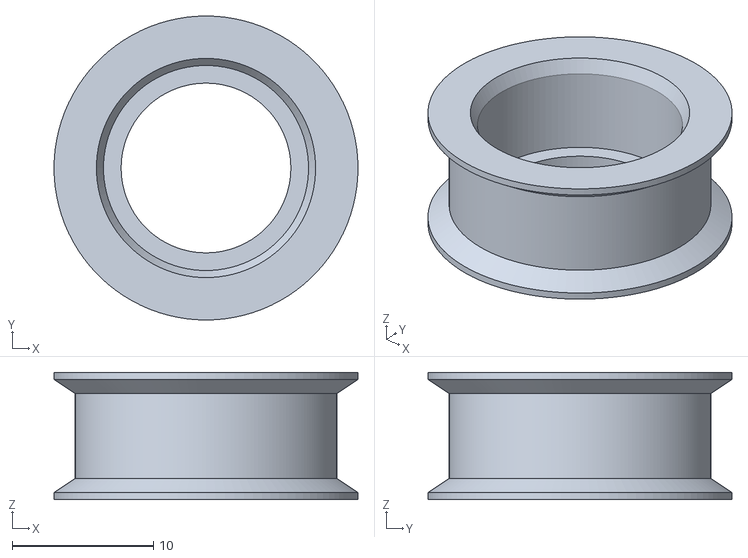
[picture p63: CAD file, 2015-01-13]
STL/RETOUR_605ZZ_PLAT_1.0 (d14.5).stl
21.5 x 21.5 x 9.00
