tobeca/Tobeca2/STL/EXTRUDEUR_SUPPORT_605ZZ_1.0.stl

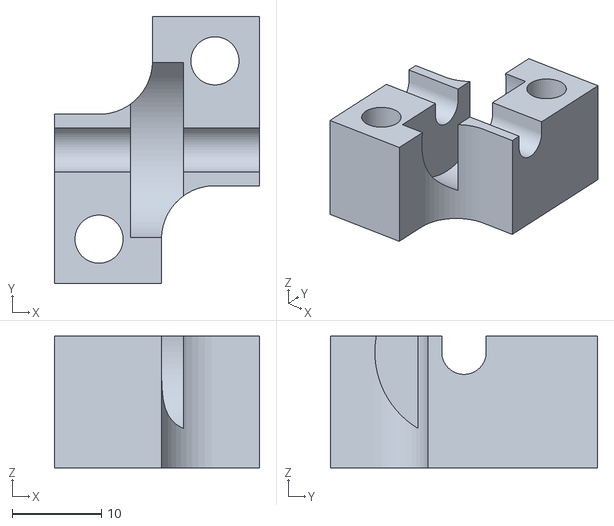
[picture p64: CAD file, 2014-11-28]
STL/EXTRUDEUR_SUPPORT_605ZZ_1.0.stl
23.0 x 30.0 x 14.8
