tobeca/Tobeca2/STL/FLANC_LCD_1.0.stl

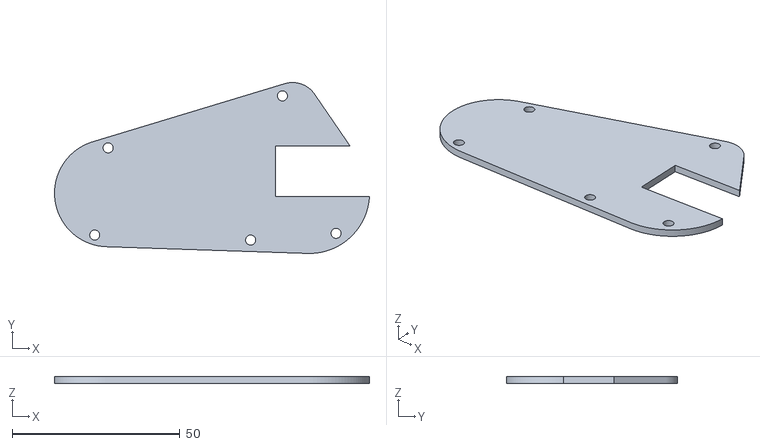
[picture p65: CAD file, 2014-11-28]
STL/FLANC_LCD_1.0.stl
94.0 x 51.0 x 2.00
