tobeca/Tobeca2/STL/FIX_CHARIOT_X_1.0.stl

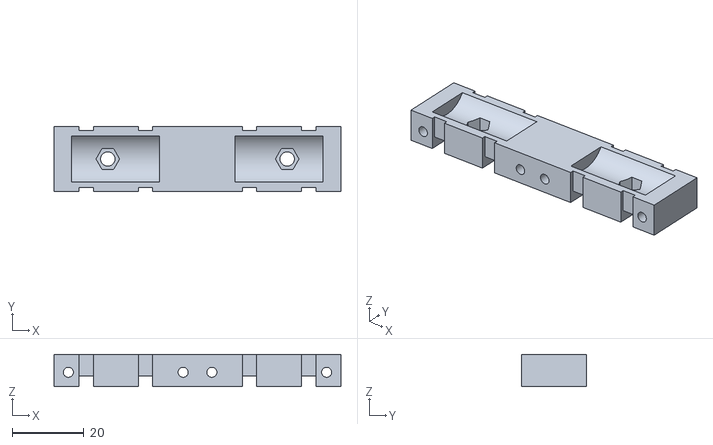
[picture p66: CAD file, 2014-11-28]
STL/FIX_CHARIOT_X_1.0.stl
80.0 x 18.0 x 9.00
