tobeca/Tobeca2/STL/SUPPORT_BOBINE_1.0.stl

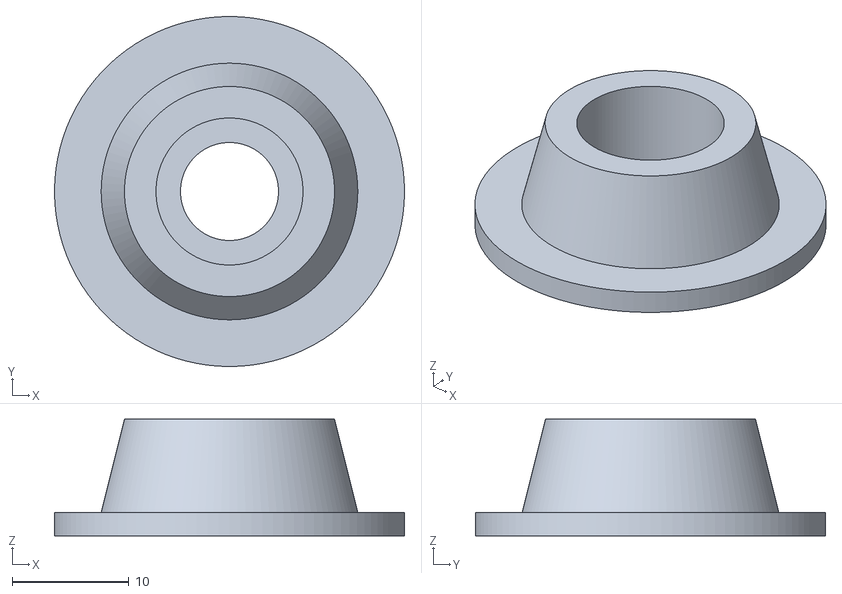
[picture p67: CAD file, 2014-09-10]
STL/SUPPORT_BOBINE_1.0.stl
30.0 x 30.0 x 10.0
