tobeca/Tobeca2/STL/CLIP_ENDSTOP_Y_1.0.stl

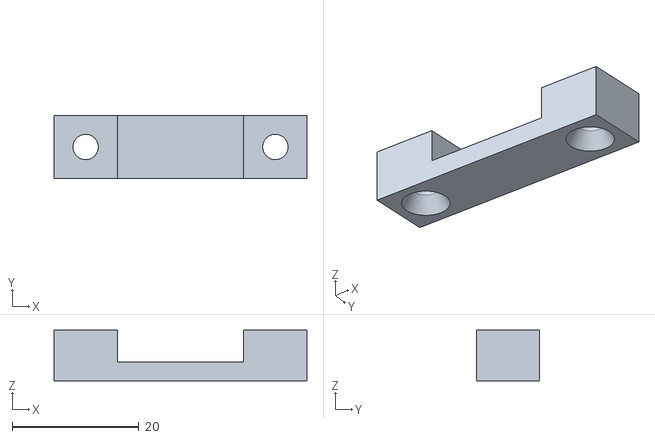
[picture p68: CAD file, 2014-07-15]
STL/CLIP_ENDSTOP_Y_1.0.stl
40.0 x 10.0 x 8.00
