tobeca/Tobeca2/STL/SUPPORT_ENDSTOP_X_1.0.stl

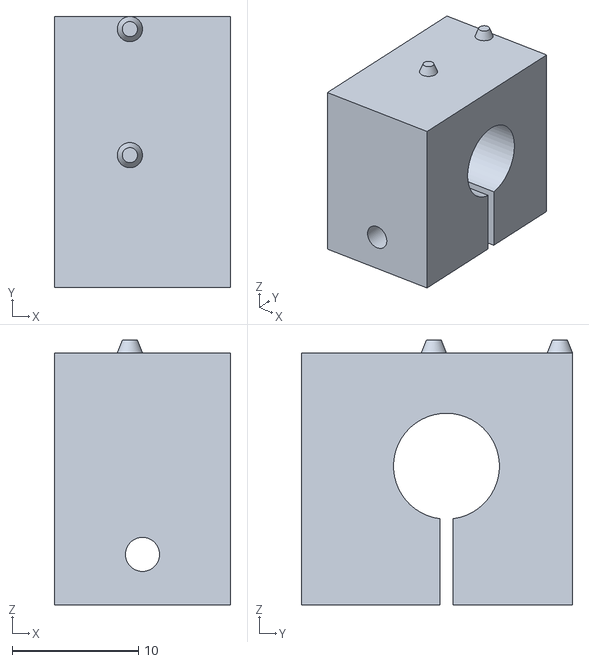
[picture p69: CAD file, 2014-07-15]
STL/SUPPORT_ENDSTOP_X_1.0.stl
14.0 x 21.5 x 21.0
