tobeca/Tobeca2/STL/SUPPORT_AXE_Y_1.0.stl

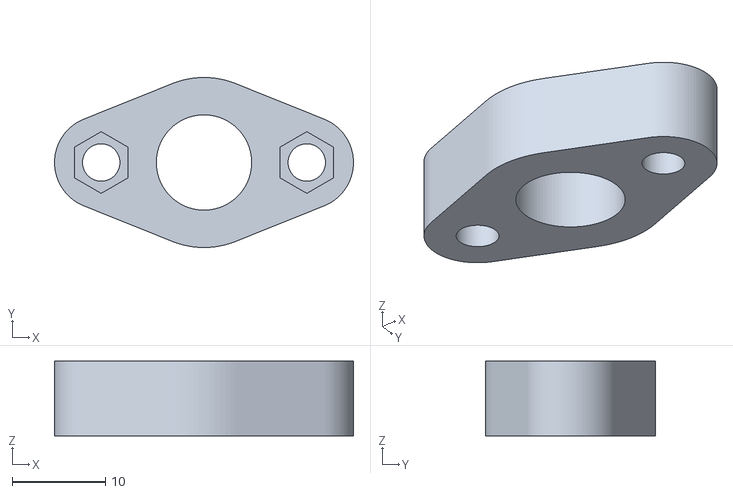
[picture p70: CAD file, 2014-06-24]
STL/SUPPORT_AXE_Y_1.0.stl
32.0 x 18.2 x 8.00
