tobeca/Tobeca2/STL/SUPPORT_ENDTOP_Z_1.0.stl

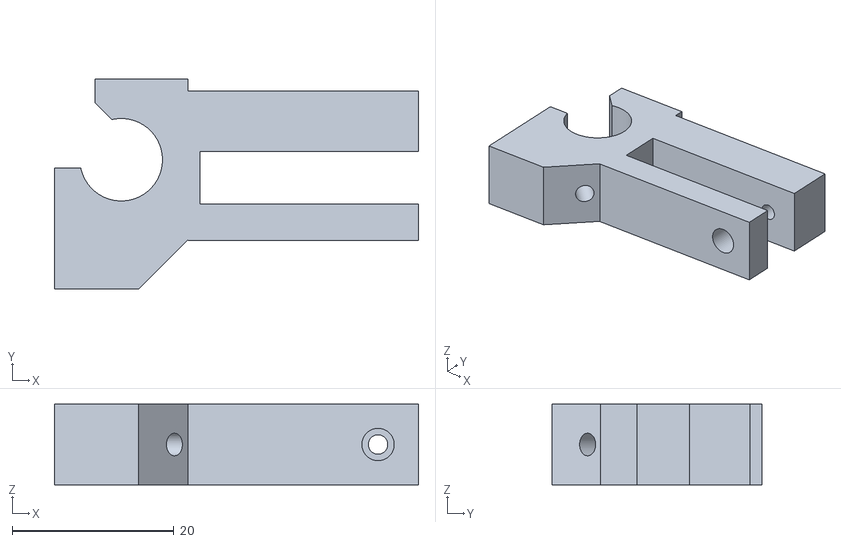
[picture p71: CAD file, 2014-06-24]
STL/SUPPORT_ENDTOP_Z_1.0.stl
45.0 x 26.0 x 10.0
