tobeca/Tobeca2/STL/CLIP_PLATEAU_1.0.stl

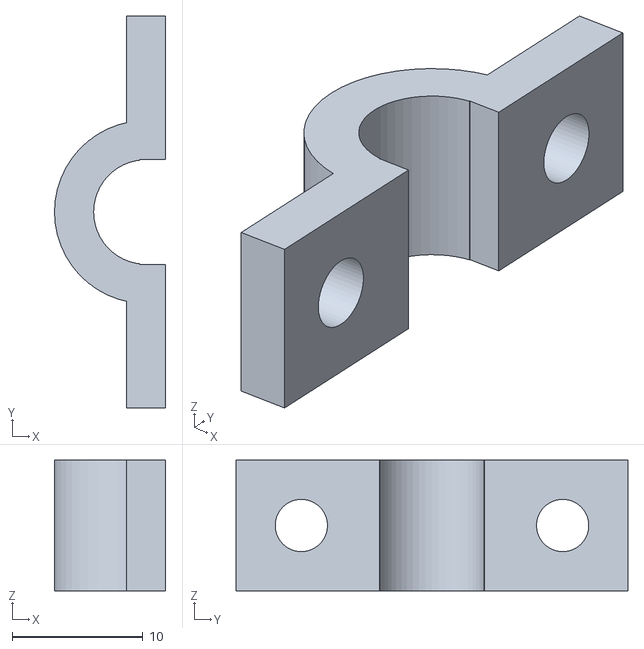
[picture p72: CAD file, 2014-06-24]
STL/CLIP_PLATEAU_1.0.stl
8.50 x 30.0 x 10.0
