tobeca/Tobeca2/SCAD/BOITIER_LCD.scad

r_ext=16;
ep=2;
hauteur=103;
r_vis=1.4;

module boitier(){
	difference(){
		hull(){
			cylinder(h = hauteur, r = r_ext, $fn=100);
			translate([60,0,0]){cylinder(h = hauteur, r = r_ext+2, $fn=100);}
			translate([55,25,0]){cylinder(h = hauteur, r = 8, $fn=100);}
		}

		//évidement intérieur général
		hull(){
			translate([0,0,-2])cylinder(h = hauteur+5, r = r_ext-ep, $fn=100);
			translate([60,0,-2]){cylinder(h = hauteur+5, r = r_ext+2-ep, $fn=100);}
			translate([55,25,-2]){cylinder(h = hauteur+5, r = 6, $fn=100);}
		}
		//ouvertures pour écran
		translate([7,-r_ext-5,12.5]){cube([26,10,78]);}

		//trou pour encodeur
		translate([59,-r_ext-5,63]){rotate([-90,0,0])cylinder(h = 15, r = 6, $fn=50);}
		
		
	}

	//ajout pour vissage des flancs
	difference(){
		union(){
			translate([-4,-r_ext+3.5,0])cylinder(h = hauteur, r = 2.5, $fn=50);
			translate([0,r_ext-2.5,0])cylinder(h = hauteur, r = 2.5, $fn=50);
			translate([42.5,-r_ext+2,0])cylinder(h = hauteur, r = 2.5, $fn=50);
			translate([52,29,0])cylinder(h = hauteur, r = 2.5, $fn=50);
			translate([68,-r_ext+4,0])cylinder(h = hauteur, r = 2.5, $fn=50);
		}

		translate([-4,-r_ext+3.5,-2])cylinder(h = hauteur+10, r = r_vis, $fn=50);
		translate([0,r_ext-2.5,-2])cylinder(h = hauteur+10, r = r_vis, $fn=50);
		translate([42.5,-r_ext+2,-2])cylinder(h = hauteur+10, r = r_vis, $fn=50);
		translate([52,29,-2])cylinder(h = hauteur+10, r = r_vis, $fn=50);
		translate([68,-r_ext+4,-2])cylinder(h = hauteur+10, r = r_vis, $fn=50);
	}
	

}

module capot(){
	difference(){
        union(){
            hull(){
                cylinder(h = ep, r = r_ext, $fn=100);
                translate([60,0,0]){cylinder(h = ep, r = r_ext+2, $fn=100);}
                translate([55,25,0]){cylinder(h = ep, r = 8, $fn=100);}
            }
            //déport pour maintenir l'écran en place
            translate([-r_ext+19,-r_ext+13,-7]){cube([10,5,7]);}
            translate([-r_ext+43,-r_ext+13,-7]){cube([10,5,7]);}
            translate([-r_ext+19,-r_ext+ep,-2.5]){cube([34,11,2.5]);}
            
        }
        //trous de vissage
        translate([-4,-r_ext+3.5,-2])cylinder(h = hauteur+10, r = 1.5, $fn=50);
        translate([0,r_ext-2.5,-2])cylinder(h = hauteur+10, r = 1.5, $fn=50);
        translate([42.5,-r_ext+2,-2])cylinder(h = hauteur+10, r = 1.5, $fn=50);
        translate([52,29,-2])cylinder(h = hauteur+10, r = 1.5, $fn=50);
        translate([68,-r_ext+4,-2])cylinder(h = hauteur, r = 1.5, $fn=50);

        //trou pour carte SD
        translate([50,-5,-2]){cube([30,10,5]);}
	}
}

//boitier();
//rotate([180,0,0])mirror(1,0,0)capot();
rotate([180,0,0])capot();
//capot();
