tobeca/Tobeca2/(list of files, cad)

Other CAD files:
EN COURS D'ETUDE/EQUERRE_NEMA14_WANTAI.stl
STL/CARTER_EQUERRE_AVANT_DROITE.stl
STL/PLAQUE_ARRIERE+USB_1.1.stl
STL/EXTRUDEUR_2.4.stl
STL/EQUERRE_NEMA14_1.4.stl
STL/BOITIER_PANELONE_1.2_ARRIERE.stl
STL/EQUERRE_NEMA14_1.2.stl
STL/PLAQUE_ARRIERE+USB_1.0.stl
STL/EXTRUDEUR_2.3.stl
STL/FLANC_LCD_GAUCHE_1.0.stl
STL/BOITIER_LCD_1.1.stl
STL/EQUERRE_NEMA14_1.1.stl
STL/PLAQUE_ARRIERE_1.0.stl
STL/PLAQUE_SERRAGE_FLANC_2.0.stl
STL/EQUERRE_NEMA14_1.0.stl
SCAD/EQUERRE_NEMA14.scad
SCAD/EQUERRE_NEMA14_WANTAI.scad
SCAD/EXTRUDEUR3MM+SUPPORT_605ZZ.scad
SCAD/GUIDE_CABLE_Z.scad
SCAD/MOLETTE_HAUTE.scad
SCAD/SUPPORT_ENDTOP_Z.scad
AMELIORATIONS CLIENTS/modification-extrudeur-lain49/EXTRUDEUR+SUPPORT_605ZZ_modification_av_alain49.scad
AMELIORATIONS CLIENTS/poussoir-protège-doigt-tea-innovation/files/poussoir.skp
ARCHIVES/BOITIER LCD/ARRIERE_LCD+PIED_LCD.scad
ARCHIVES/BOITIER LCD/ROUE_LCD.scad
ARCHIVES/BOITIER_LCD.scad
ARCHIVES/BOITIER_RAMPS.scad
ARCHIVES/CALEPINAGE_MALLETTE.skp
ARCHIVES/CAPOT_RAMPS.scad
ARCHIVES/Carter Tobeca2.skp
ARCHIVES/EQUERRE_NEMA14.scad
ARCHIVES/EQUERRE_NEMA14_ANCIEN_MODELE.stl
ARCHIVES/EXTRUDEUR+SUPPORT_605ZZ.scad
ARCHIVES/EXTRUDEUR+SUPPORT_608ZZ (2).scad
ARCHIVES/EXTRUDEUR+SUPPORT_608ZZ.scad
ARCHIVES/EXTRUDEUR_DOUBLE+SUPPORT_605ZZ.scad
ARCHIVES/FIX_CHARIOT_X (2).scad
ARCHIVES/FIX_CHARIOT_X (3).scad
ARCHIVES/FIX_CHARIOT_X.scad
ARCHIVES/FIX_CHARIOT_X.stl
ARCHIVES/FIX_CHARIOT_X_PROD.scad
ARCHIVES/FIX_CHARIOT_X_PROD.stl
ARCHIVES/PANELOLU2.skp
ARCHIVES/PLAQUE_SERRAGE_FLANC.skp
ARCHIVES/RETOUR_608ZZ_PLAT.scad
ARCHIVES/RETOUR_X.scad
ARCHIVES/RETOUR_Y.scad
ARCHIVES/SUPPORT_ENDSTOP_X_old.scad
ARCHIVES/SUPPORT_FAN.scad
ARCHIVES/SUPPORT_FAN.stl
ARCHIVES/SUPPORT_FAN_X.scad
ARCHIVES/amélioration ventilation.skp
ARCHIVES/j-head.SLDPRT
EN COURS D'ETUDE/ARCHIVES/EQUERRE_NEMA14_TEST.scad
EN COURS D'ETUDE/PLAQUE_ARRIERE+USB.skp
SCAD/SUPPORT_AXE_Y.scad
SCAD/archives/EQUERRE_NEMA14 (2).scad
SCAD/archives/EQUERRE_NEMA14.scad
SCAD/archives/EXTRUDEUR+SUPPORT_605ZZ.scad
SCAD/archives/SUPPORT_ENDTOP_Z.scad
SKP/BOITIER_PANELONE_1.3.skp
SKP/BOITIER_RAMPS.skp
SKP/CARTER/CARTER226.skp
SKP/CARTER/CARTER_ARRIERE.skp
SKP/CARTER/CARTER_COTE_DROITE.skp
SKP/CARTER/CARTER_COTE_GAUCHE.skp
SKP/CARTER/CARTER_DESSUS.skp
SKP/CARTER/CARTER_PMMA6MM_V4.dxf
SKP/CARTER/CARTER_PORTE.skp
SKP/CARTER/REGROUPEMENT_PIECES.skp
SKP/CARTER226/CARTER_ARRIERE.skp
SKP/CARTER226/CARTER_COTE_DROITE.skp
SKP/CARTER226/CARTER_COTE_GAUCHE.skp
SKP/CARTER226/CARTER_DESSUS.skp
SKP/CARTER226/CARTER_PORTE.skp
SKP/Carter Tobeca2.skp
SKP/DIRIGE_FLUX.skp
SKP/ECRAN_LCD.skp
SKP/PLAQUE_ARRIERE+USB.skp
SKP/PLAQUE_ARRIERE.skp
SKP/PLAQUE_SERRAGE_FLANC.skp
SKP/SUPPORT_BOBINE_605.skp
SKP/Tobeca 2 Edition 2016 Boite 1.1.skp
STL/ARCHIVES/BOITIER_LCD_1.1.stl
STL/ARCHIVES/BOITIER_PANELONE_1.2_ARRIERE.stl
STL/ARCHIVES/EQUERRE_NEMA14_1.1.stl
STL/ARCHIVES/EQUERRE_NEMA14_1.2.stl
STL/ARCHIVES/EXTRUDEUR.stl
STL/ARCHIVES/EXTRUDEUR_2.3.stl
STL/ARCHIVES/FLANC_LCD_GAUCHE_1.0.stl
STL/ARCHIVES/PLAQUE_ARRIERE+USB_1.0.stl
STL/ARCHIVES/PLAQUE_SERRAGE_FLANC_2.0.stl
USINAGES/CALEPINAGE_MALLETTE.skp
USINAGES/CALEPINAGE_MALLETTE_V2.0.skp
USINAGES/CALEPINAGE_PANNEAU_TOBECA_2016.skp
USINAGES/FRAISAGE_ARRIERE.skp
USINAGES/FRAISAGE_SUPPORT_PLATEAU.skp
USINAGES/PLAQUE_ALU_X.skp
USINAGES/SUPPORT_AXE_X/SUPPORT_AXE_X_ALU.skp
