tobeca/Tobeca2/AMELIORATIONS CLIENTS/nouveau-porte-bobine-et-guide-lumiere-led-atlantis94.txt

http://www.tobeca.fr/forums/topic/mon-nouveau-porte-bobines-et-guides-lumiere-pour-led-du-boitier/
