tobeca/Tobeca2/USINAGES/TOBECA2_CHASSIS.pdf

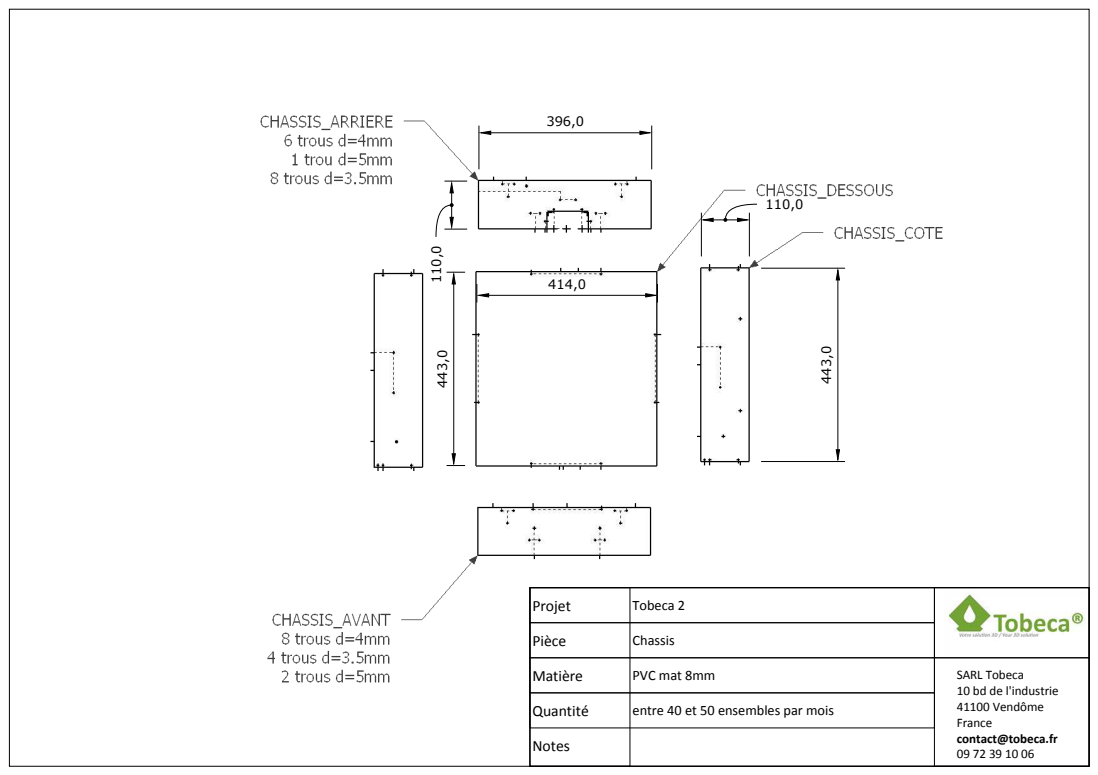
[picture p73: page 1]

Projet | Tobeca 2

Pièce | Chassis

Matière | PVC mat 8mm | SARL Tobeca 10 bd de l'industrie 41100 Vendôme France contact@tobeca.fr 09 72 39 10 06

Quantité | entre 40 et 50 ensembles par mois

Notes
