tobeca/Tobeca2/USINAGES/SUPPORT_AXE_X/support_axe_x_alu.pdf

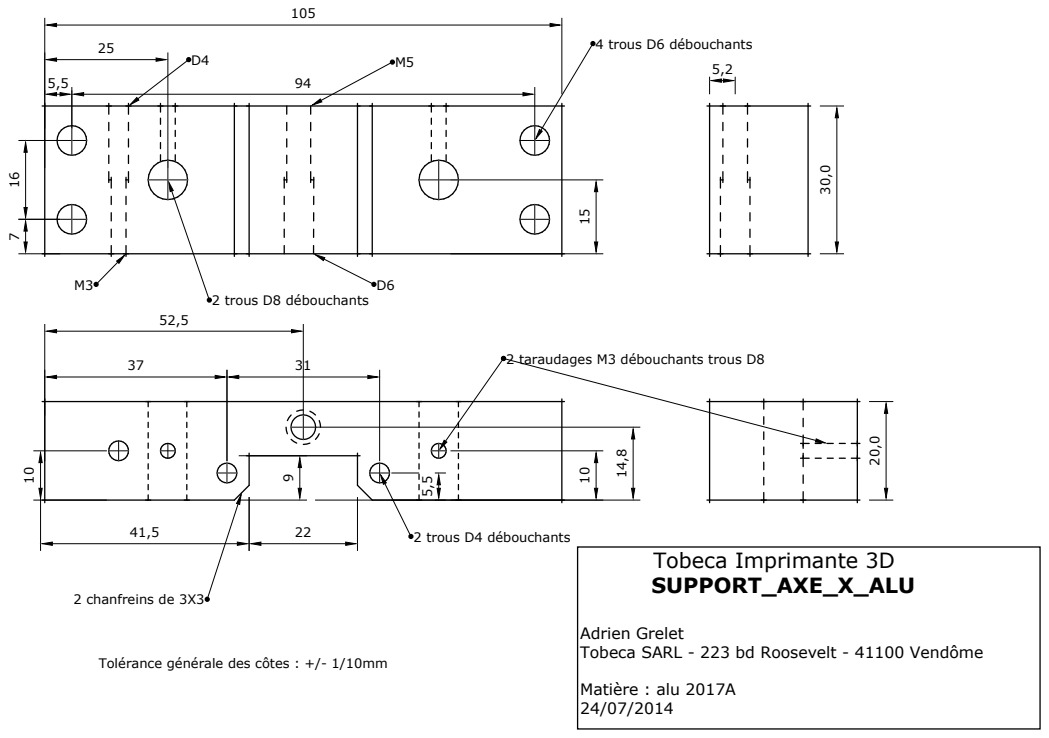
[picture p74: page 1]
Tobeca Imprimante 3D; Matière : alu 2017A; 4 trous D6 débouchants; 2 trous D8 débouchants; 2 trous D4 débouchants; 2 chanfreins de 3X3

2 taraudages M3 débouchants trous D8

Adrien Grelet
Tobeca SARL - 223 bd Roosevelt - 41100 Vendôme

Tolérance générale des côtes : +/- 1/10mm
