tobeca/Tobeca2/USINAGES/CALEPINAGE_PANNEAU_TOBECA_2016.pdf

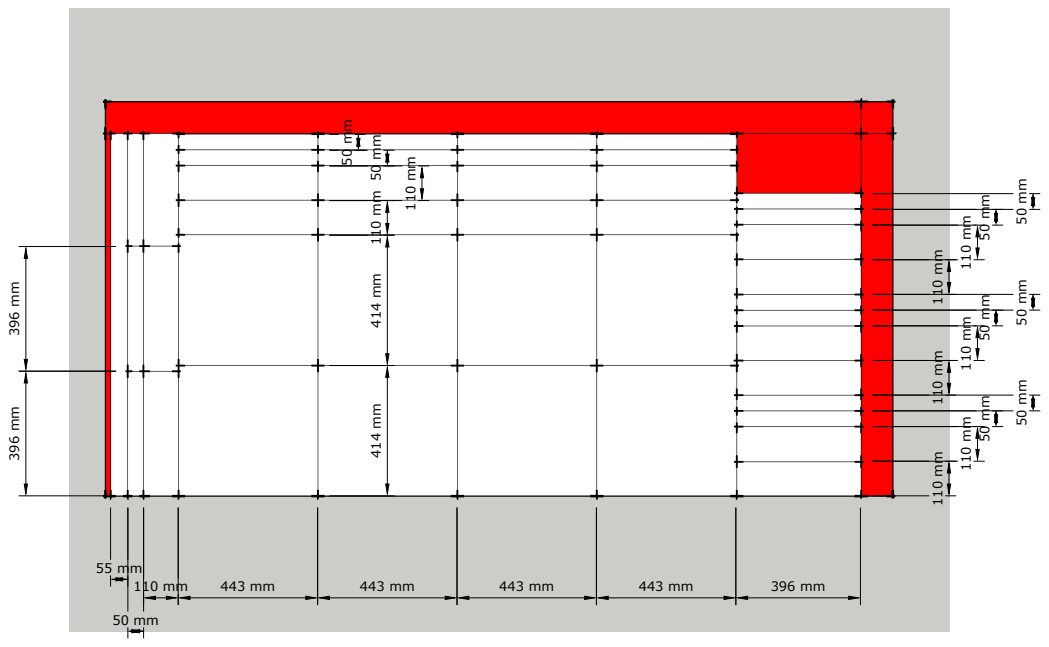
[picture p75: page 1]
