tobeca/Tobeca2/USINAGES/PLAQUE_ALU_X.pdf

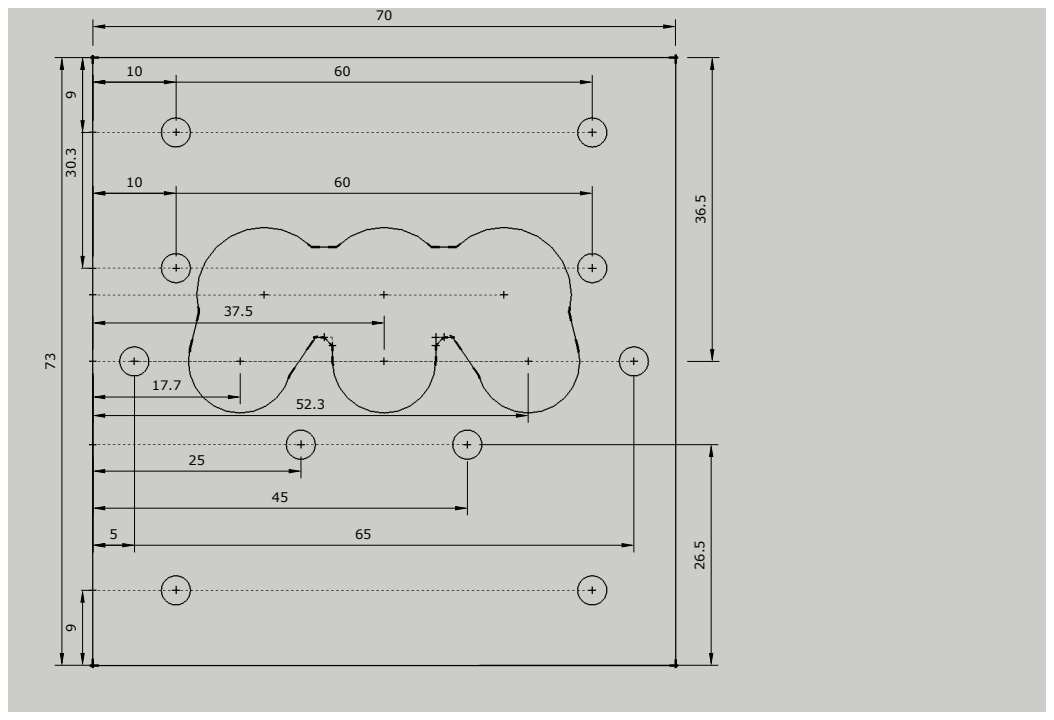
[picture p76: page 1]
