tobeca/Tobeca2/(commit log)

2014-06-24 premier commit pour la Tobeca 2
    [ARRIERE_LCD+PIED_LCD.scad, BASE_Z.scad, BASE_Z.stl, BLOCAGE_ARBRE_Y.scad, BOITIER_RAMPS.scad, BOITIER_RAMPS.stl, BOM.ods, Bearing LM8UU.skp]
2014-06-24 resynchro de démarrage
    [SUPPORT_LASER.scad, SUPPORT_LASER.stl]
2014-07-15 mise à jour
    [BOITE_EXTRUDEUR.STL, BOITIER_RAMPS.scad, BOITIER_RAMPS.stl, BRIDE_3VOIES.STL, CALEPINAGE.skp, CAPOT_RAMPS.scad, CAPOT_RAMPS.stl, CLIP_ENDSTOP_Y.scad]
2014-07-22 nouvelles versions pièces
    [BOITE_EXTRUDEUR.STL, BRIDE_3VOIES.STL, EQUERRE_NEMA14.scad, EQUERRE_NEMA14.stl, EXTRUDEUR_DOUBLE+SUPPORT_605ZZ.scad, EXTRUDEUR_DOUBLE.stl, EXTRUDEUR_DOUBLE_SUPPORT_605ZZ.stl, FIX_CHARIOT_X.scad]
2014-09-10 pièces de test
    [CALEPINAGE.skp, CAPOT_RAMPS.scad, CAPOT_RAMPSv2.stl, EXTRUDEUR_DOUBLE+SUPPORT_605ZZ.scad, EXTRUDEUR_DOUBLE.stl, EXTRUDEUR_DOUBLE_SUPPORT_605ZZ.stl, FIX_CHARIOT_X.scad, FIX_CHARIOT_X.stl]
2014-09-16 maj nouvelles pieces
    [BOITIER_LCD.scad, BOITIER_LCD.stl, FIX_CHARIOT_X_PROD.scad, FIX_CHARIOT_X_PROD.stl, FLANC_LCD.stl, Intégration boitier LCD.skp, PARTS LIST GROUPES.ods, SUPPORT_BOBINE.scad]
2014-10-10 changement fixation des profils
    [ARRIERE.skp, BLOCAGE_ARBRE_Y.scad, CALEPINAGE.skp, CALEPINAGE_MALLETTE.skp, Carter métal.dxf, Carter métal.skp, Configuration.h, EQUERRE_NEMA14.scad]
2014-10-29 ajout plans carter tobeca
    [ARRIERE.skp, Bearing LM8UU.skp, CALEPINAGE_MALLETTE.skp, Carter Tobeca2.skp, FRAISAGE_ARRIERE.skp, FRAISAGE_SUPPORT_PLATEAU.skp, PLAQUE_ALU_X.dxf, PLAQUE_ALU_X.skp]
2014-11-28 Nouveau boitier LCD
    [ARRIERE.skp, ARRIERE_LCD+PIED_LCD.scad, BOITIER_LCD.scad, BOITIER_LCD.stl, Bearing LM8UU.skp, CALEPINAGE_MALLETTE.skp, Configuration.h, EXTRUDEUR+SUPPORT_608ZZ.scad]
2015-01-13 Mise en production du nouvel extrudeur
    [BOITIER.skp, BOITIER_RAMPS.scad, BOITIER_RAMPS.stl, Bearing LM8UU.skp, CAPOT_RAMPS.scad, CAPOT_RAMPS.stl, Configuration.h, EXTRUDEUR_DOUBLE+SUPPORT_605ZZ.scad]
2015-02-05 Mises à jour pour Tobeca 2.0
    Pour coller à la nouvelle documentation
    [ARRIERE.skp, ARRIERE_LCD.stl, BOITIER_LCD_1.0.stl, BOITIER_RAMPS_1.0.stl, CALEPINAGE_MALLETTE.skp, CAPOT_RAMPS_1.0.stl, CAPOT_RAMPSv2.stl, CLIP_ENDSTOP_Y_1.0.stl]
2015-02-18 configuration.h adapté pour les kits
    [Configuration.h, MOLETTE_PETITE_1.0.stl, PARTS LIST.ods, SUPPORT_LASER_1.0.stl]
2015-04-13 Nouveau boitier LCD
    Nouveau boitier LCD avec flancs permettant de bien maintenir en place
    l'écran sans vis.
    Ajout du bouton pour l'écran.
    [BOITIER_LCD.scad, BOITIER_LCD_1.0.stl, BOITIER_LCD_1.1.stl, BOUTON_LCD.scad, BOUTON_LCD_1.0.stl, CALEPINAGE_MALLETTE_V2.0.skp, Configurationold.h, EQUERRE_NEMA14.scad]
2015-04-29 Nouvelle version extrudeur 2.2
    [BOITIER_LCD.scad, Configuration.h, Configuration_adv.h, EXTRUDEUR+SUPPORT_605ZZ.scad, EXTRUDEUR+SUPPORT_605ZZ_1.75.scad, EXTRUDEUR+SUPPORT_605ZZ_1.75_1.0.stl, EXTRUDEUR_2.1.stl, EXTRUDEUR_2.2.stl]
2015-06-26 Nouvelle version Marlin
    L'ancienne version reste disponible avec la mention "Marlinold"
    [BOUTON_LCD.scad, Configuration.h, Configuration_adv.h, Configurationold.h, EXTRUDEUR+SUPPORT_605ZZ.scad, EXTRUDEUR_SUPPORT_605ZZ_1.1.stl, Menu Plans.xlsx, PARTS LIST.ods]
2015-07-07 ajout arduino addons
    [Configuration.h, Configuration_adv.h, Marlin Logo.dxf, Menu Plans.xlsx, PARTS LIST.ods]
2015-09-04 cale pour porte carter
    [CALE_PORTE.scad, CALE_PORTE.stl, Configuration.h]
2015-10-13 nouvelle version Tobeca 2016
    [ARRIERE_LCD+PIED_LCD.scad, BOITIER.skp, BOITIER_LCD (2).scad, BOITIER_LCD.scad, BOITIER_PANELONE_1.1.skp, BOITIER_PANELONE_1.1_ARRIERE.stl, BOITIER_PANELONE_1.1_FACADE.stl, BOITIER_RAMPS.scad]
2015-10-22 modif configuration.h pour corrections
    [BRIDAGE_PLATEAU.scad, BRIDAGE_PLATEAU_1.0.stl, Configuration.h, PARTS LIST 3.0.ods, PLAQUE_ARRIERE+USB.skp, PLAQUE_ARRIERE+USB.stl, SUPPORT_BOBINE_605.scad, SUPPORT_BOBINE_605.stl]
2015-11-16 màj diverses
    [BOITIER_PANELONE_1.1.skp, BOITIER_PANELONE_1.1_FACADE.stl, BOITIER_PANELONE_1.2_ARRIERE.stl, CLIP_ENDSTOP_Y (Copie en conflit de Lenovo-Adrien 2015-09-21).scad, EQUERRE_NEMA14.scad, EQUERRE_NEMA14.stl, EQUERRE_NEMA14_1.3.stl, PARTS LIST 3.1.ods]
2015-11-20 Ajout du sélecteur d'extrudeur depuis l'écran LCD
    Afin de piloter l'extrusion en manuel sur les deux extrudeurs.
2015-11-23 correction FW
    Mauvaise copie de fichiers
2015-12-04 nouveau SUPPORT_ENDSTOP_X pour avoir un réglage de la course X
    [BOITIER_PANELONE_1.1.skp, BOITIER_PANELONE_1.3.skp, BOITIER_PANELONE_1.3_ARRIERE.stl, BOITIER_PANELONE_1.3_FACADE.stl, CARTER_ARRIERE.skp, CARTER_COTE_DROITE.skp, CARTER_COTE_GAUCHE.skp, CARTER_DESSUS.skp]
2015-12-07 support endstop x suite retour client v2
    [SUPPORT_ENDSTOP_X.scad, SUPPORT_ENDSTOP_X.stl]
2015-12-07 màj version support bobine 605
    [SUPPORT_BOBINE_605_1.0.stl]
2015-12-21 Nouveau support endstop X
    Plus court, pour gagner en course X
    [CARTER_COTE_DROITE.skp, CARTER_PORTE.skp, PARTS LIST 3.0.ods, PARTS LIST CARTER.ods, SUPPORT_BOBINE_605.scad, SUPPORT_BOBINE_605_1.0.stl, SUPPORT_ENDSTOP_X.scad, SUPPORT_ENDSTOP_X_1.2.stl]
2016-02-29 plaque arriere usb
    [CARTER226.skp, CARTER_ARRIERE.skp, CARTER_COTE_DROITE.skp, CARTER_COTE_GAUCHE.skp, CARTER_PORTE.skp, Configuration.h, PARTS LIST 3.3.ods, PLAQUE_ARRIERE+USB_1.0.stl]
2016-04-05 Ajout pièces clients
    [CACHE VENTILO .stl, CARTER_ARRIERE.dxf, CARTER_ARRIERE.skp, CARTER_COTE_DROITE.dxf, CARTER_COTE_DROITE.skp, CARTER_COTE_GAUCHE.dxf, CARTER_COTE_GAUCHE.skp, CARTER_DESSUS.dxf]
2016-05-12 Nouveau support bobine pour carter
    [PARTS LIST 3.3.ods, SUPPORT_BOBINE_605.skp, SUPPORT_BOBINE_605_1.1.stl]
2016-12-04 dirige flux
    [CARTER_ARRIERE.skp, CARTER_EQUERRE_ARRIERE_DROITE.stl, CARTER_EQUERRE_ARRIERE_GAUCHE.stl, CARTER_EQUERRE_AVANT_DROITE.stl, CARTER_EQUERRE_AVANT_GAUCHE.stl, CARTER_PMMA6MM_V3.dxf, CARTER_PMMA6MM_V3_ERREUR.dxf, CARTER_PMMA6MM_V4.dxf]
2017-01-10 maj pidtempbed
    [CARTER_ARRIERE.skp, CARTER_COTE_DROITE.skp, CARTER_COTE_GAUCHE.skp, CARTER_DESSUS.skp, CARTER_PORTE.skp, Configuration.h, EQUERRE_NEMA14_WANTAI_1.0.stl, EXTRUDEUR3MM.stl]
